PROJECT-BIRO/Biro-1/README.md

# Biro-1
A custom media controller for computers, allowing you to easily change volume, play/pause, skip/rewind, and launch favourite applications. Currently being developed!
