PROJECT-BIRO/Biro-1/3d-models/README.md

# 3D Models
CAD files for Biro-1's case/enclosure, dial, keycaps, etc.
