PROJECT-BIRO/Biro-1/board/README.md

# Printed Circuit Board
Biro-1 schematics and PCB design files
