PROJECT-BIRO/Biro-1/board/Block Diagram/Biro-1-block-diagram.png

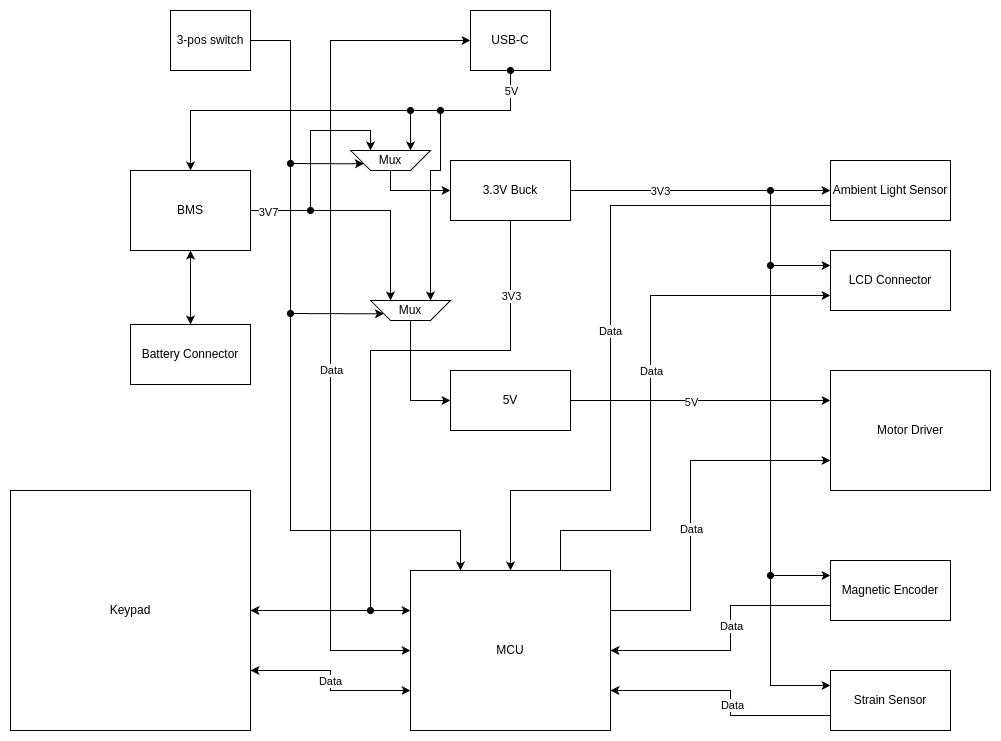
board/Block Diagram/Biro-1-block-diagram.png
