PROJECT-BIRO/Biro-1/board/rev-0/biro-1-rev-0.step

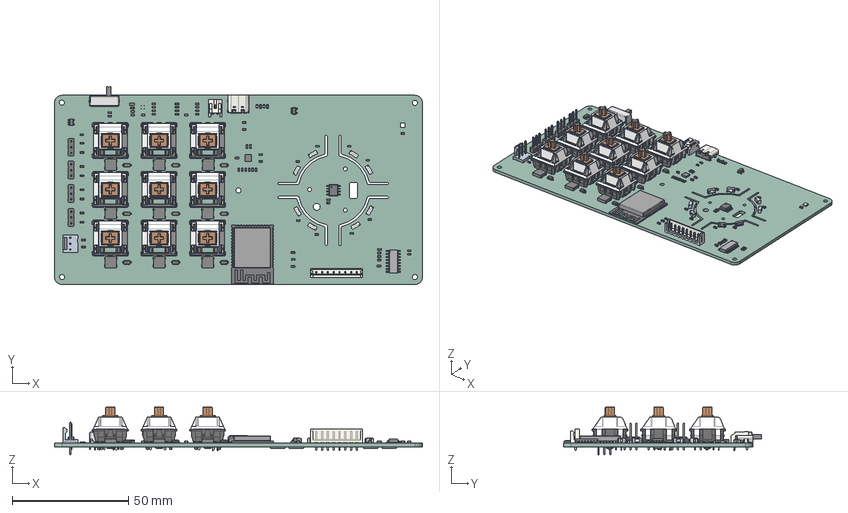
[picture p2: CAD file, 2025-09-03]
board/rev-0/biro-1-rev-0.step
158.5 x 85.2 x 20.6 mm
SW_Cherry_MX_PCB_cp x 9
R_0603_1608Metric x 32
APDS-9306-065
C_0603_1608Metric x 33
SK6812 SIDE-A x 8
CQ assembly
SOT_23_5 x 2
JST_S2B_PH_K
ESP32-S3-WROOM-1
L_0805_2012Metric
D_SOD_123 x 9
JST_B8B_EH_A
PinHeader_1x03_P254mm_Vertical x 4
SLW-1274547-4A-RA-D
LED_0603_1608Metric x 2
USB_C_Receptacle_16P_TopMnt_Horizontal_GCT_USB4105-xx-A
D_0603
R_2512_6332Metric x 4
biro-1-rev-0_PCB
