PROJECT-BIRO/Biro-1/(threads)

Thread 1 (2025-02-17):

Gather firmware libraries

Darth-Raazi, 2025-02-17:
Research which ESP32 libraries we need to use for main functions, including:
- Keys
- Dial
- Bluetooth
- Screen
- Motor

Document them somewhere

pateruu, 2025-04-01:
We are picking libraries as we go so I think it can be closed. We got main libraries selected as well, I believe.

Closed 2025-04-01.

Thread 2 (2025-02-17):

Finalize battery specs

Darth-Raazi, 2025-02-17:
Decide battery specs and configuration. Are we set on 21700? How are we going to configure the 4 cells? Which voltage, 3.7 or 7.4?

Darth-Raazi, 2025-02-21:
3.7V battery will be used as all known components require 3.3V logic, not 5V. Current idea is to configure four 3.7V 21700 cells  in parallel for max capacity

Darth-Raazi, 2025-03-03:
Motor driver requires 6-8V, will boost 3.7V up for that rather than configuring cells in parallel. May decide to add 2 circuit paths (1s and 2s configs) in the future, time and board space permitting

Closed 2025-03-03.

Thread 3 (2025-02-17):

Research BMS

Darth-Raazi, 2025-02-17:
Draft initial plan for BMS. Custom or COTS? Which ICs will we use? What's the voltage step-down/step-up path? BMS circuitry integrated into main board or as a separate daughter board?

Thread 4 (2025-02-17):

ESP32 Dev Env Setup

Darth-Raazi, 2025-02-17:
Order dev boards and setup the ESP IDF. Compile and run some test code

Darth-Raazi, 2025-02-21:
Dev boards arrived!

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

Darth-Raazi, 2025-03-03:
Others to follow setup instructions and verify that they're correct

Closed 2025-03-23.

Thread 7 (2025-02-23):

Research Motor

Darth-Raazi, 2025-02-23:
SmartKnob uses a specific motor. Look into:
- Can we get that one and for how much?
- Is there a cheaper one that works just as well?
- Are others size compatible?
- Input voltage and current draw?
- Electrical connections and firmware support

Darth-Raazi, 2025-03-03:
Decided to go with the official sparkfun motors for first boards to cut down on risk despite higher price tags

Closed 2025-03-03.
