PROJECT-BIRO/Biro-1/board/Block Diagram/Biro-1-block-diagram.pdf

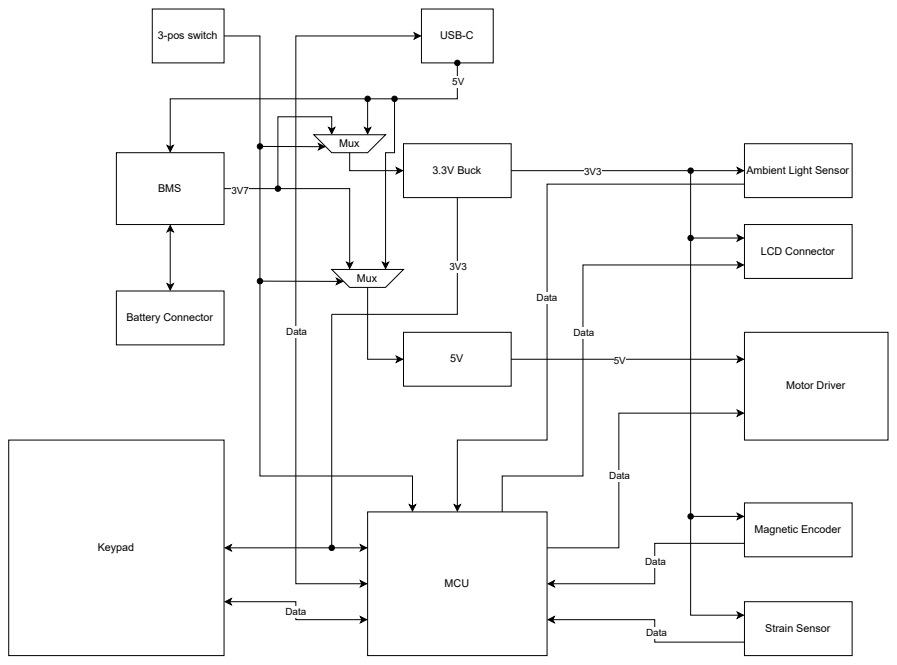
[picture p3: page 1]
3-pos switch; USB-C; MCU; Keypad; Motor Driver; LCD Connector; Magnetic Encoder; Strain Sensor; 3.3V Buck; BMS; Battery Connector; Data; Mux

Ambient Light Sensor
