PROJECT-BIRO/Biro-1/board/biro-battery-schematic/biro-0.pdf

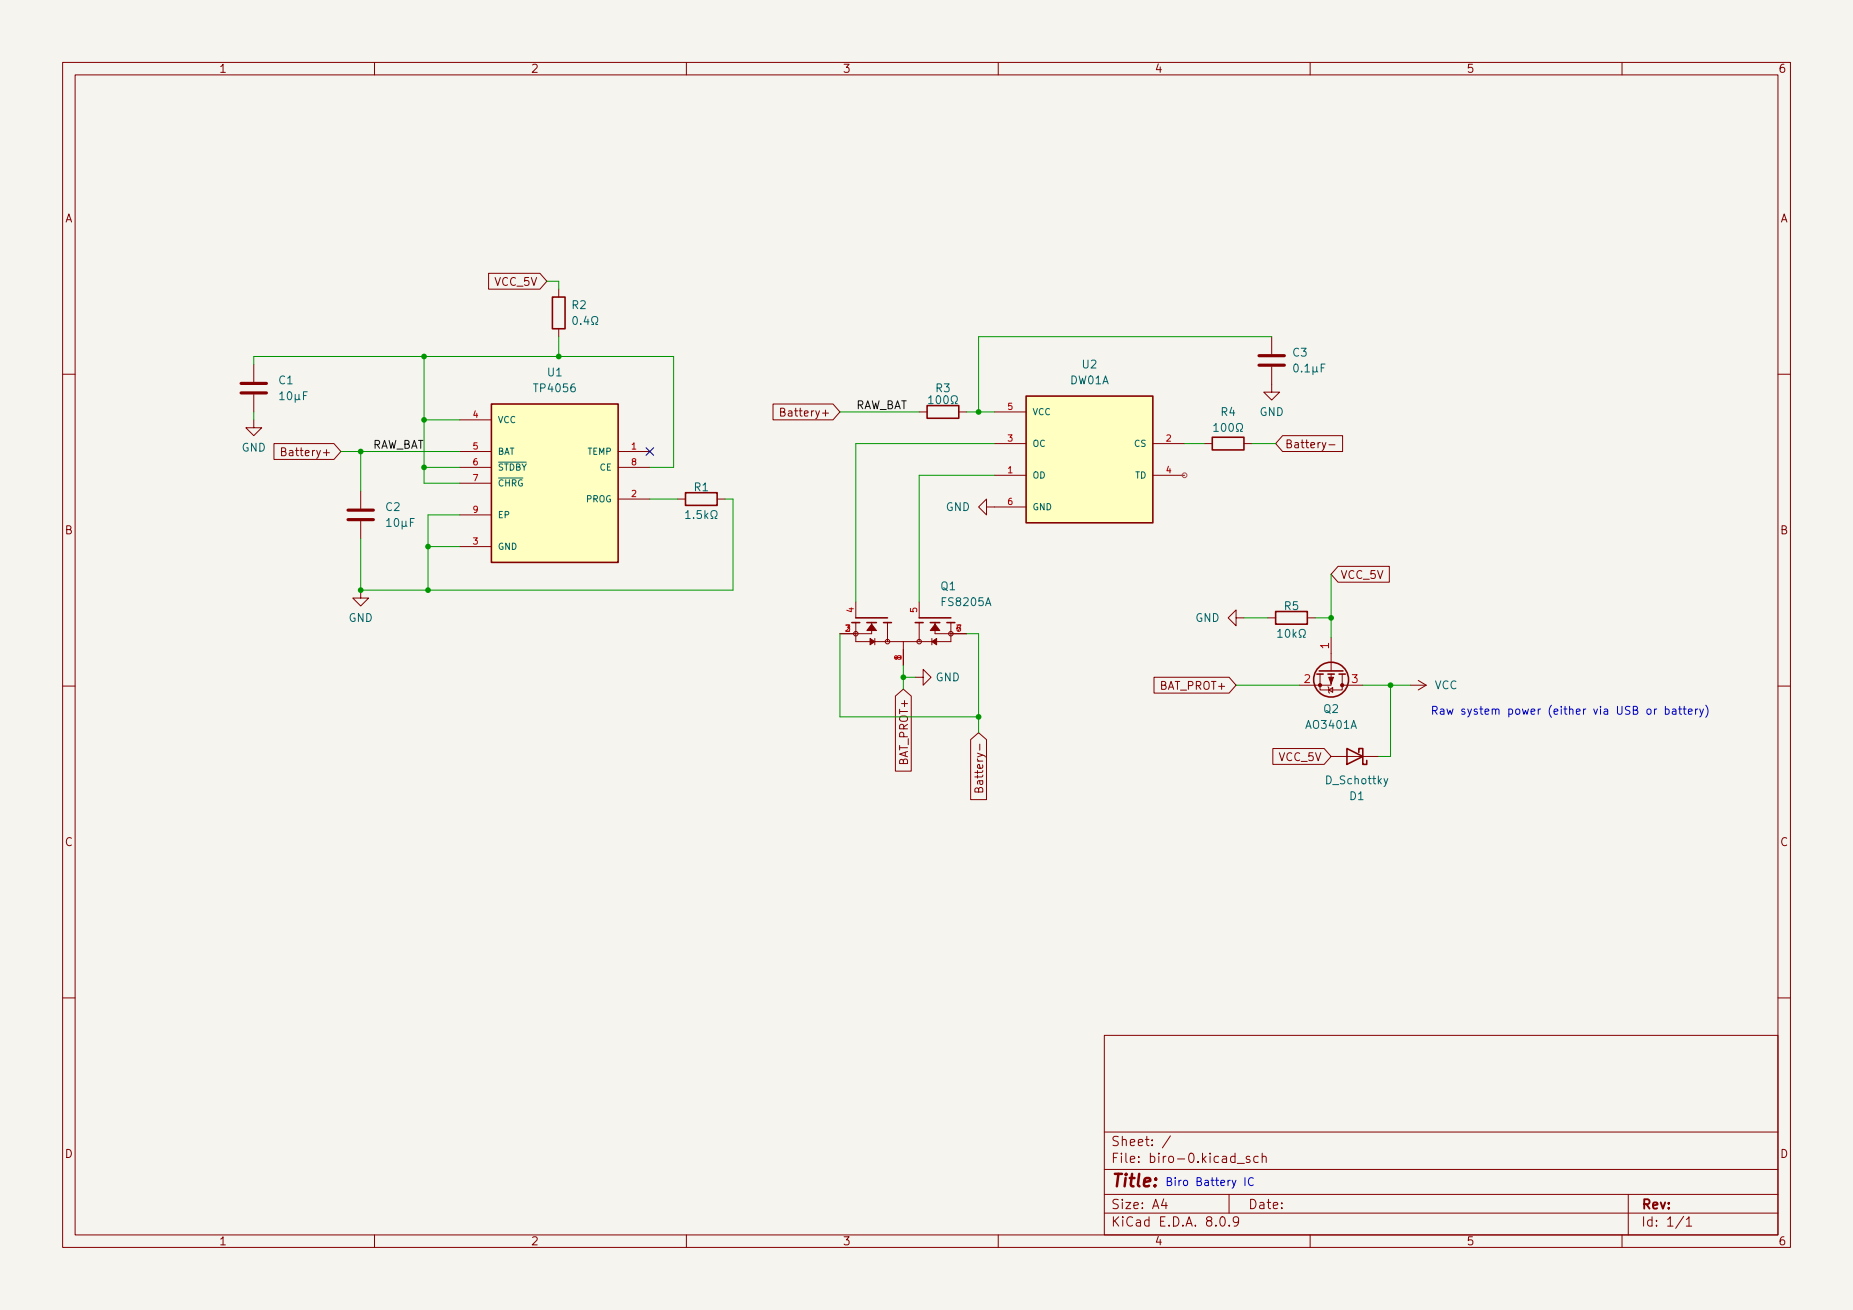
[picture p4: page 1]
