PROJECT-BIRO/Biro-1/board/rev-0/biro-1-rev-0.pdf

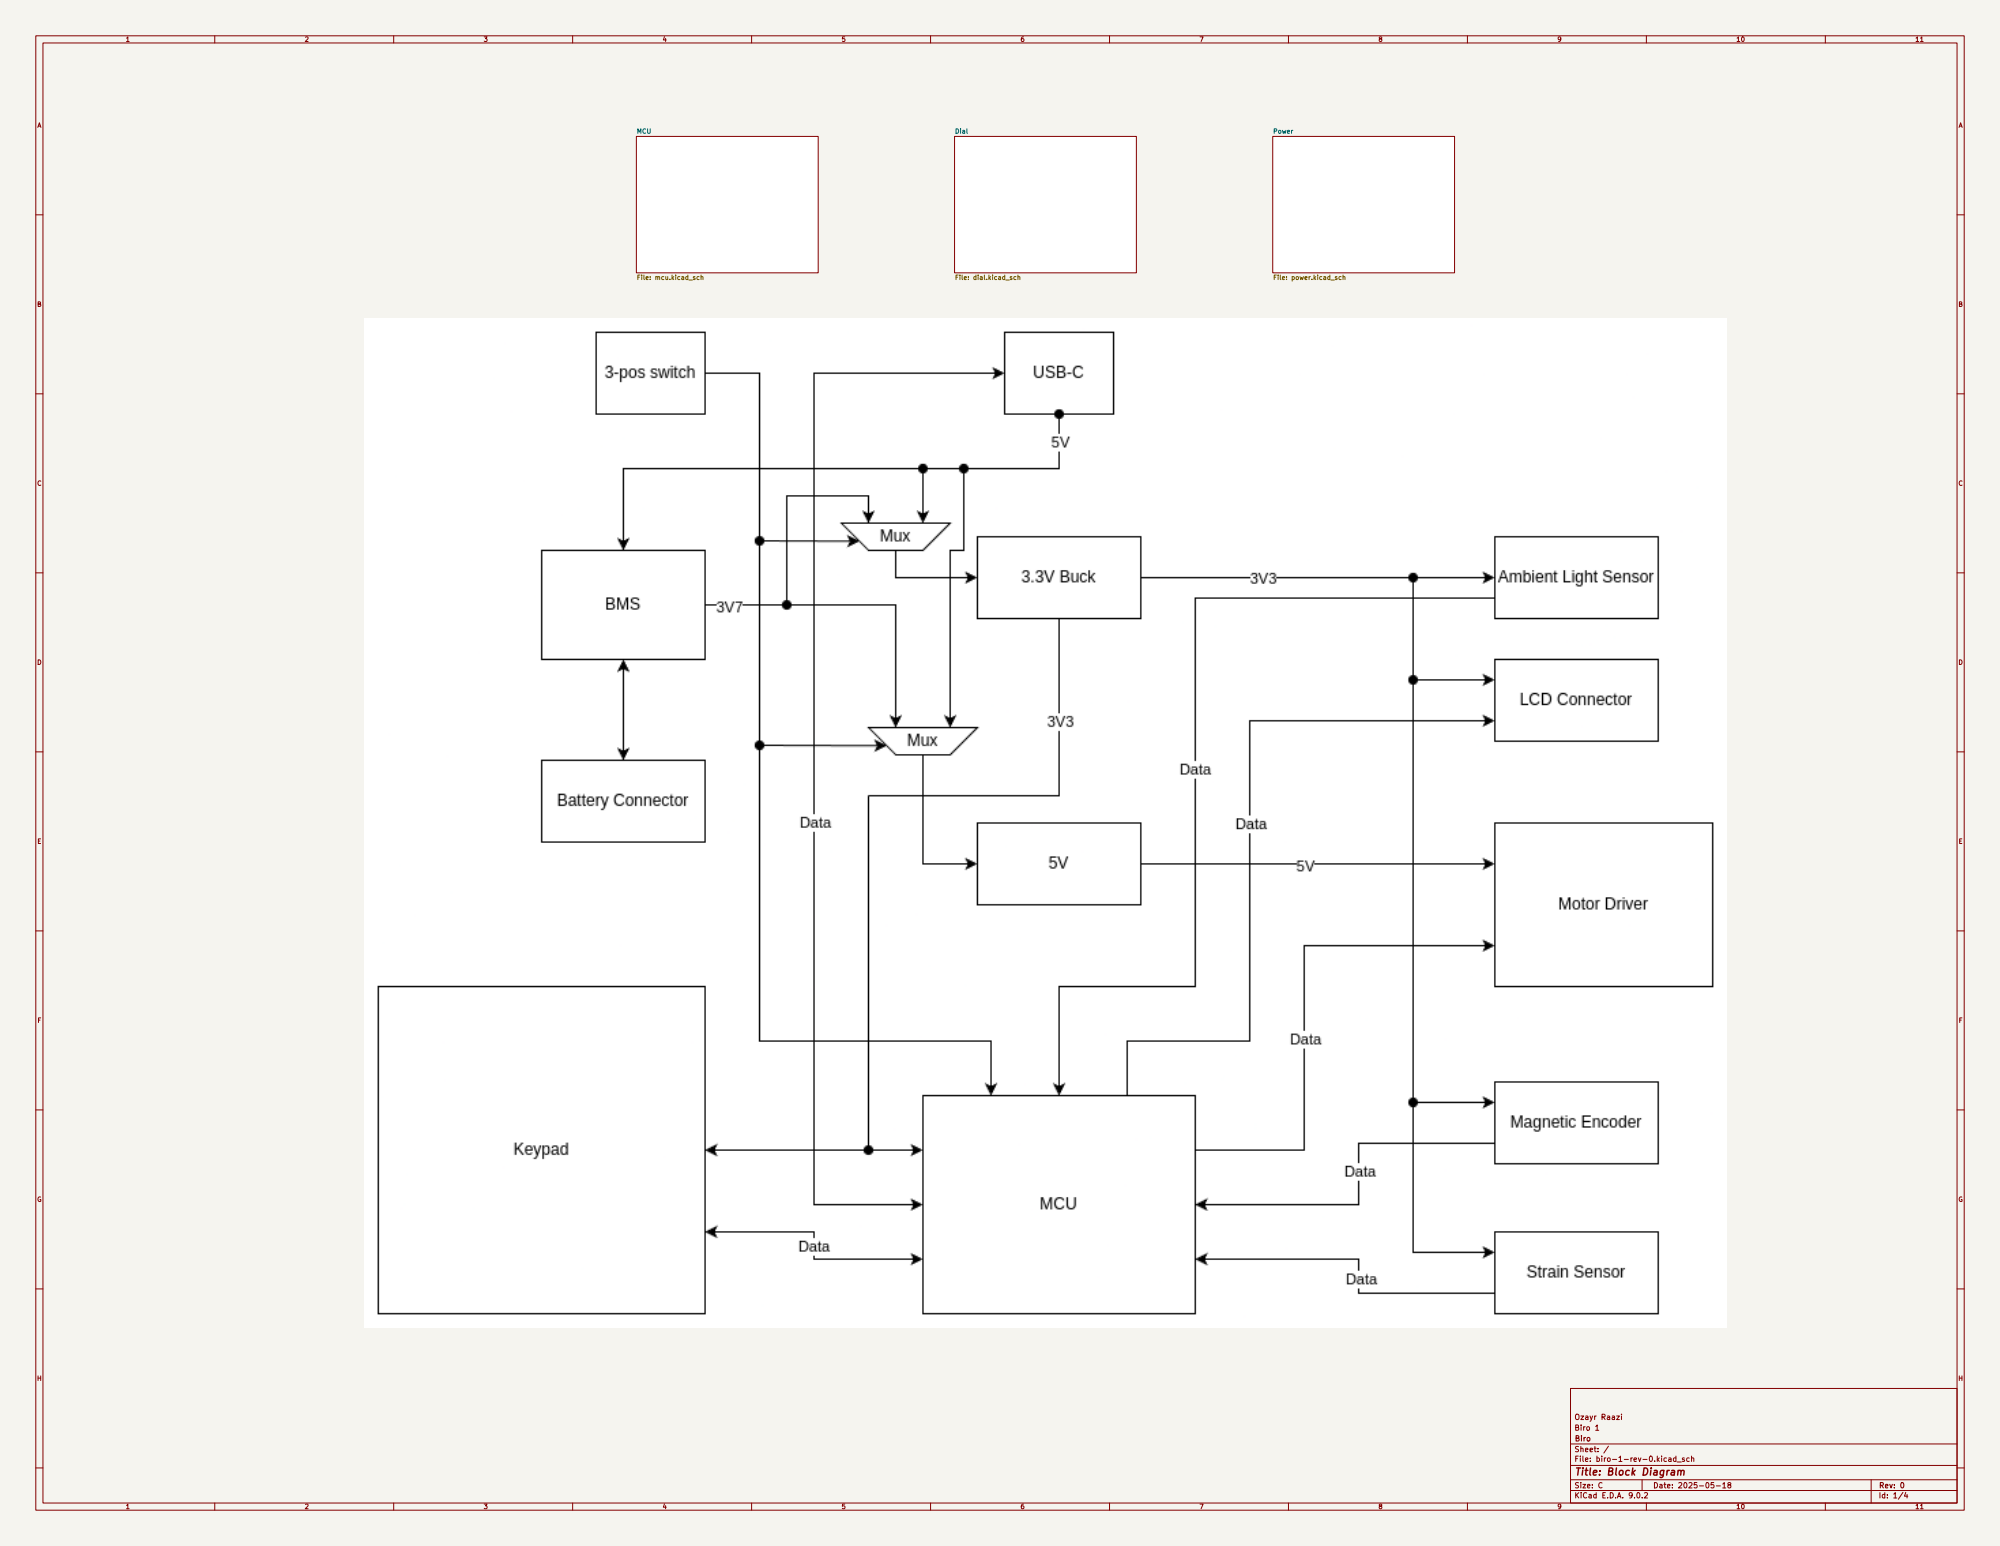
[picture p5: page 1]

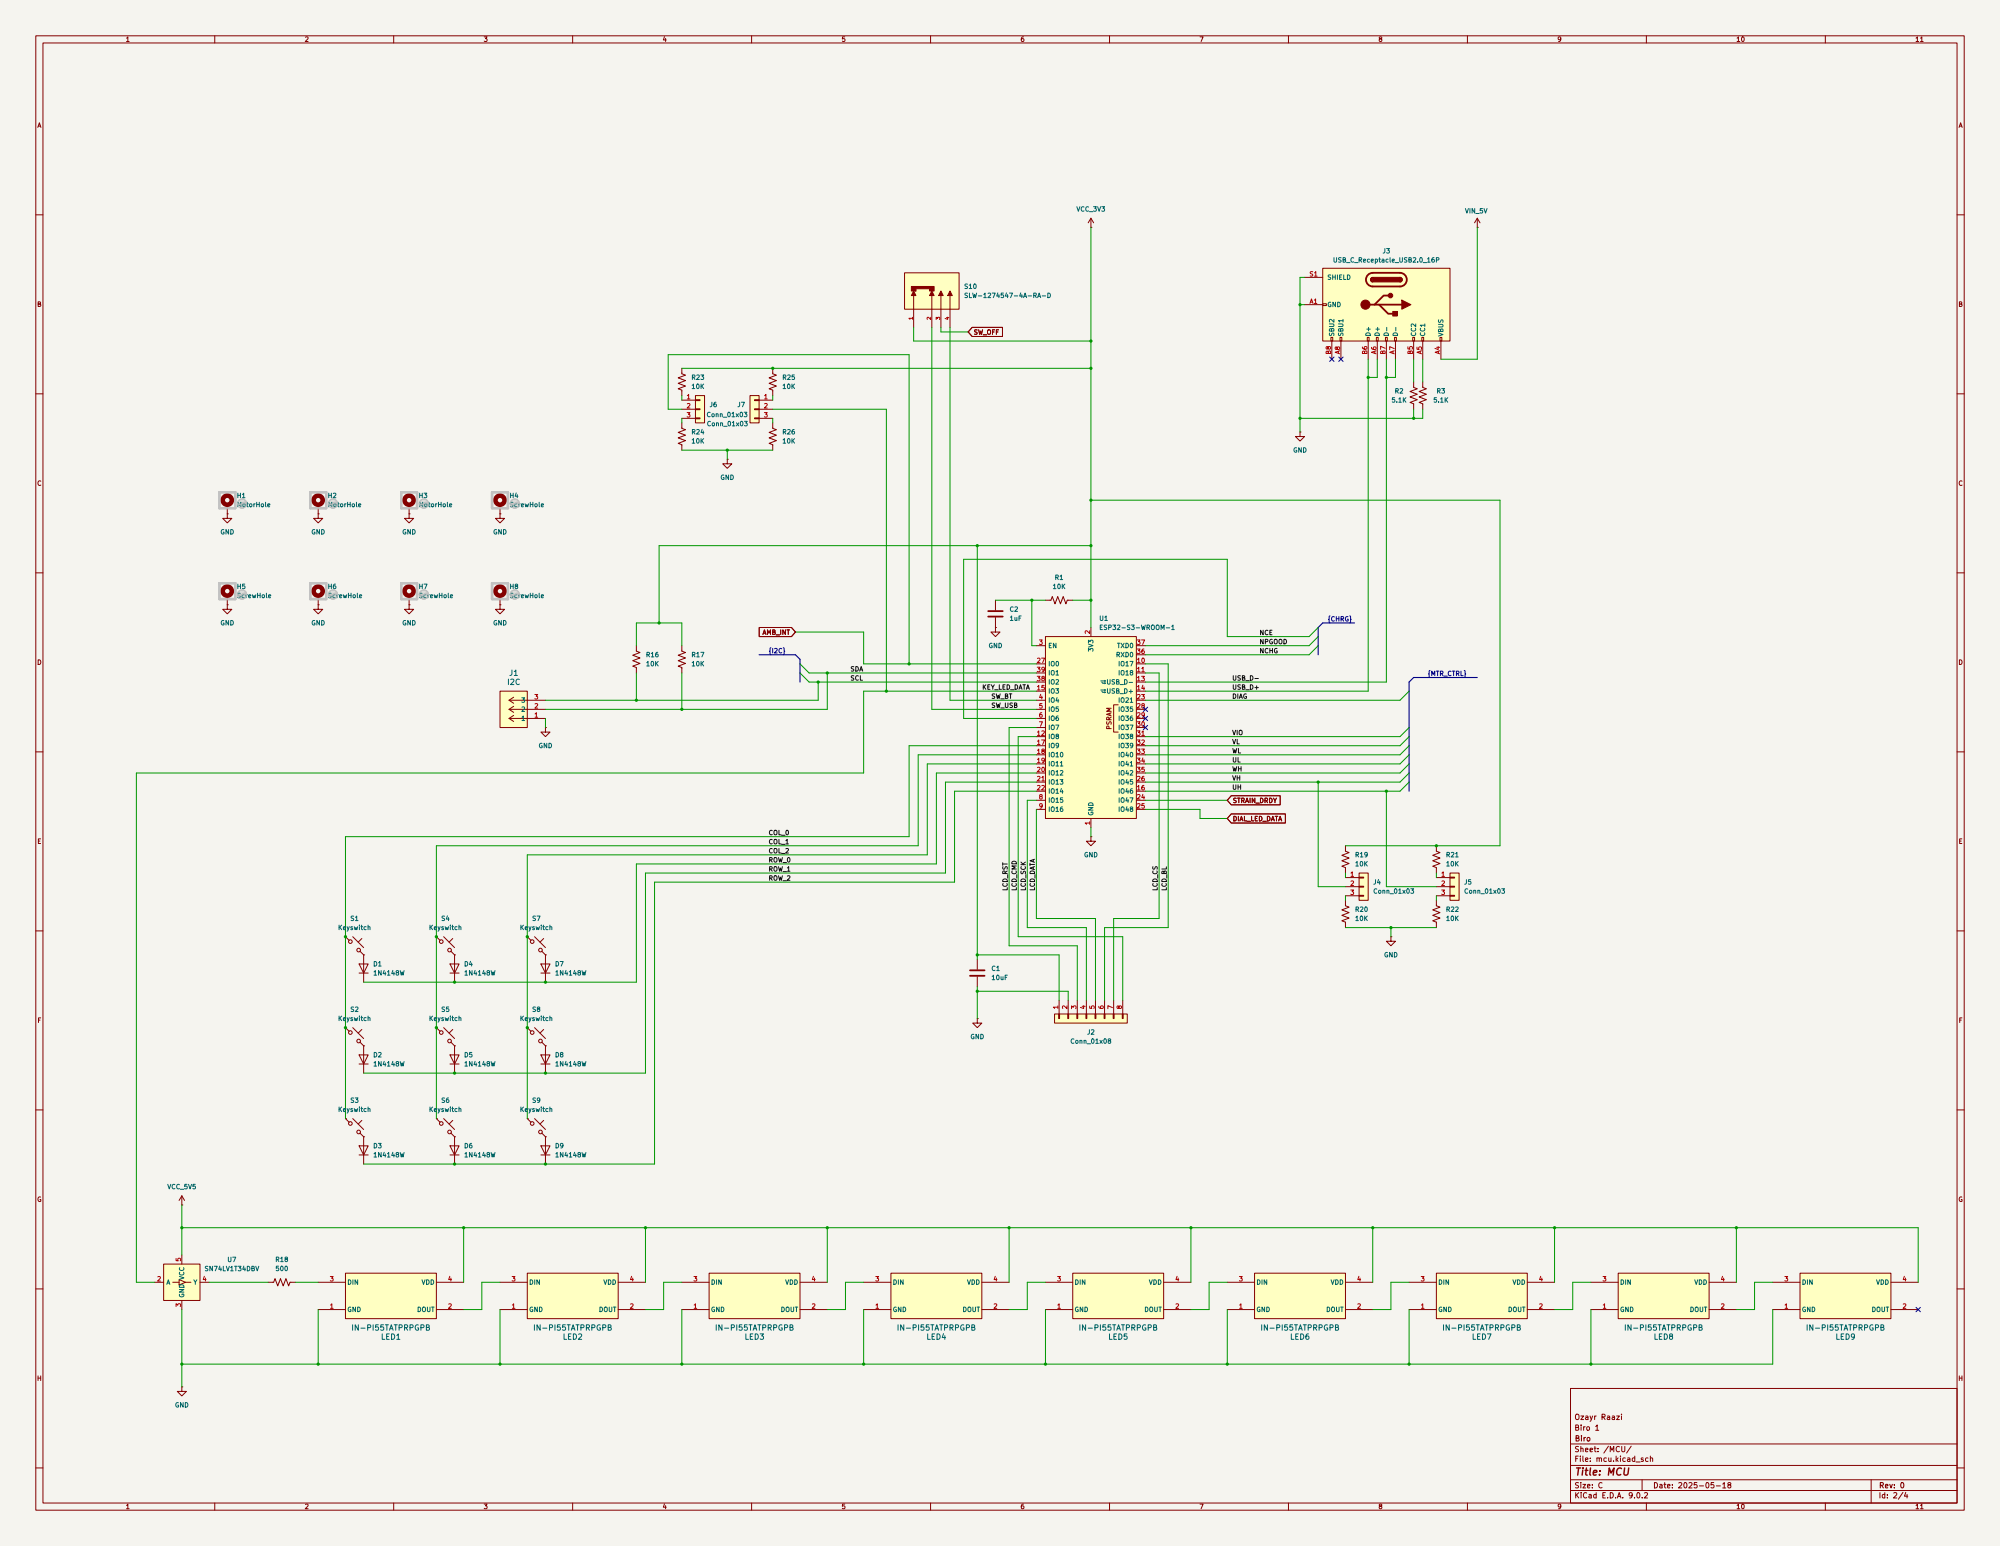
[picture p6: page 2]

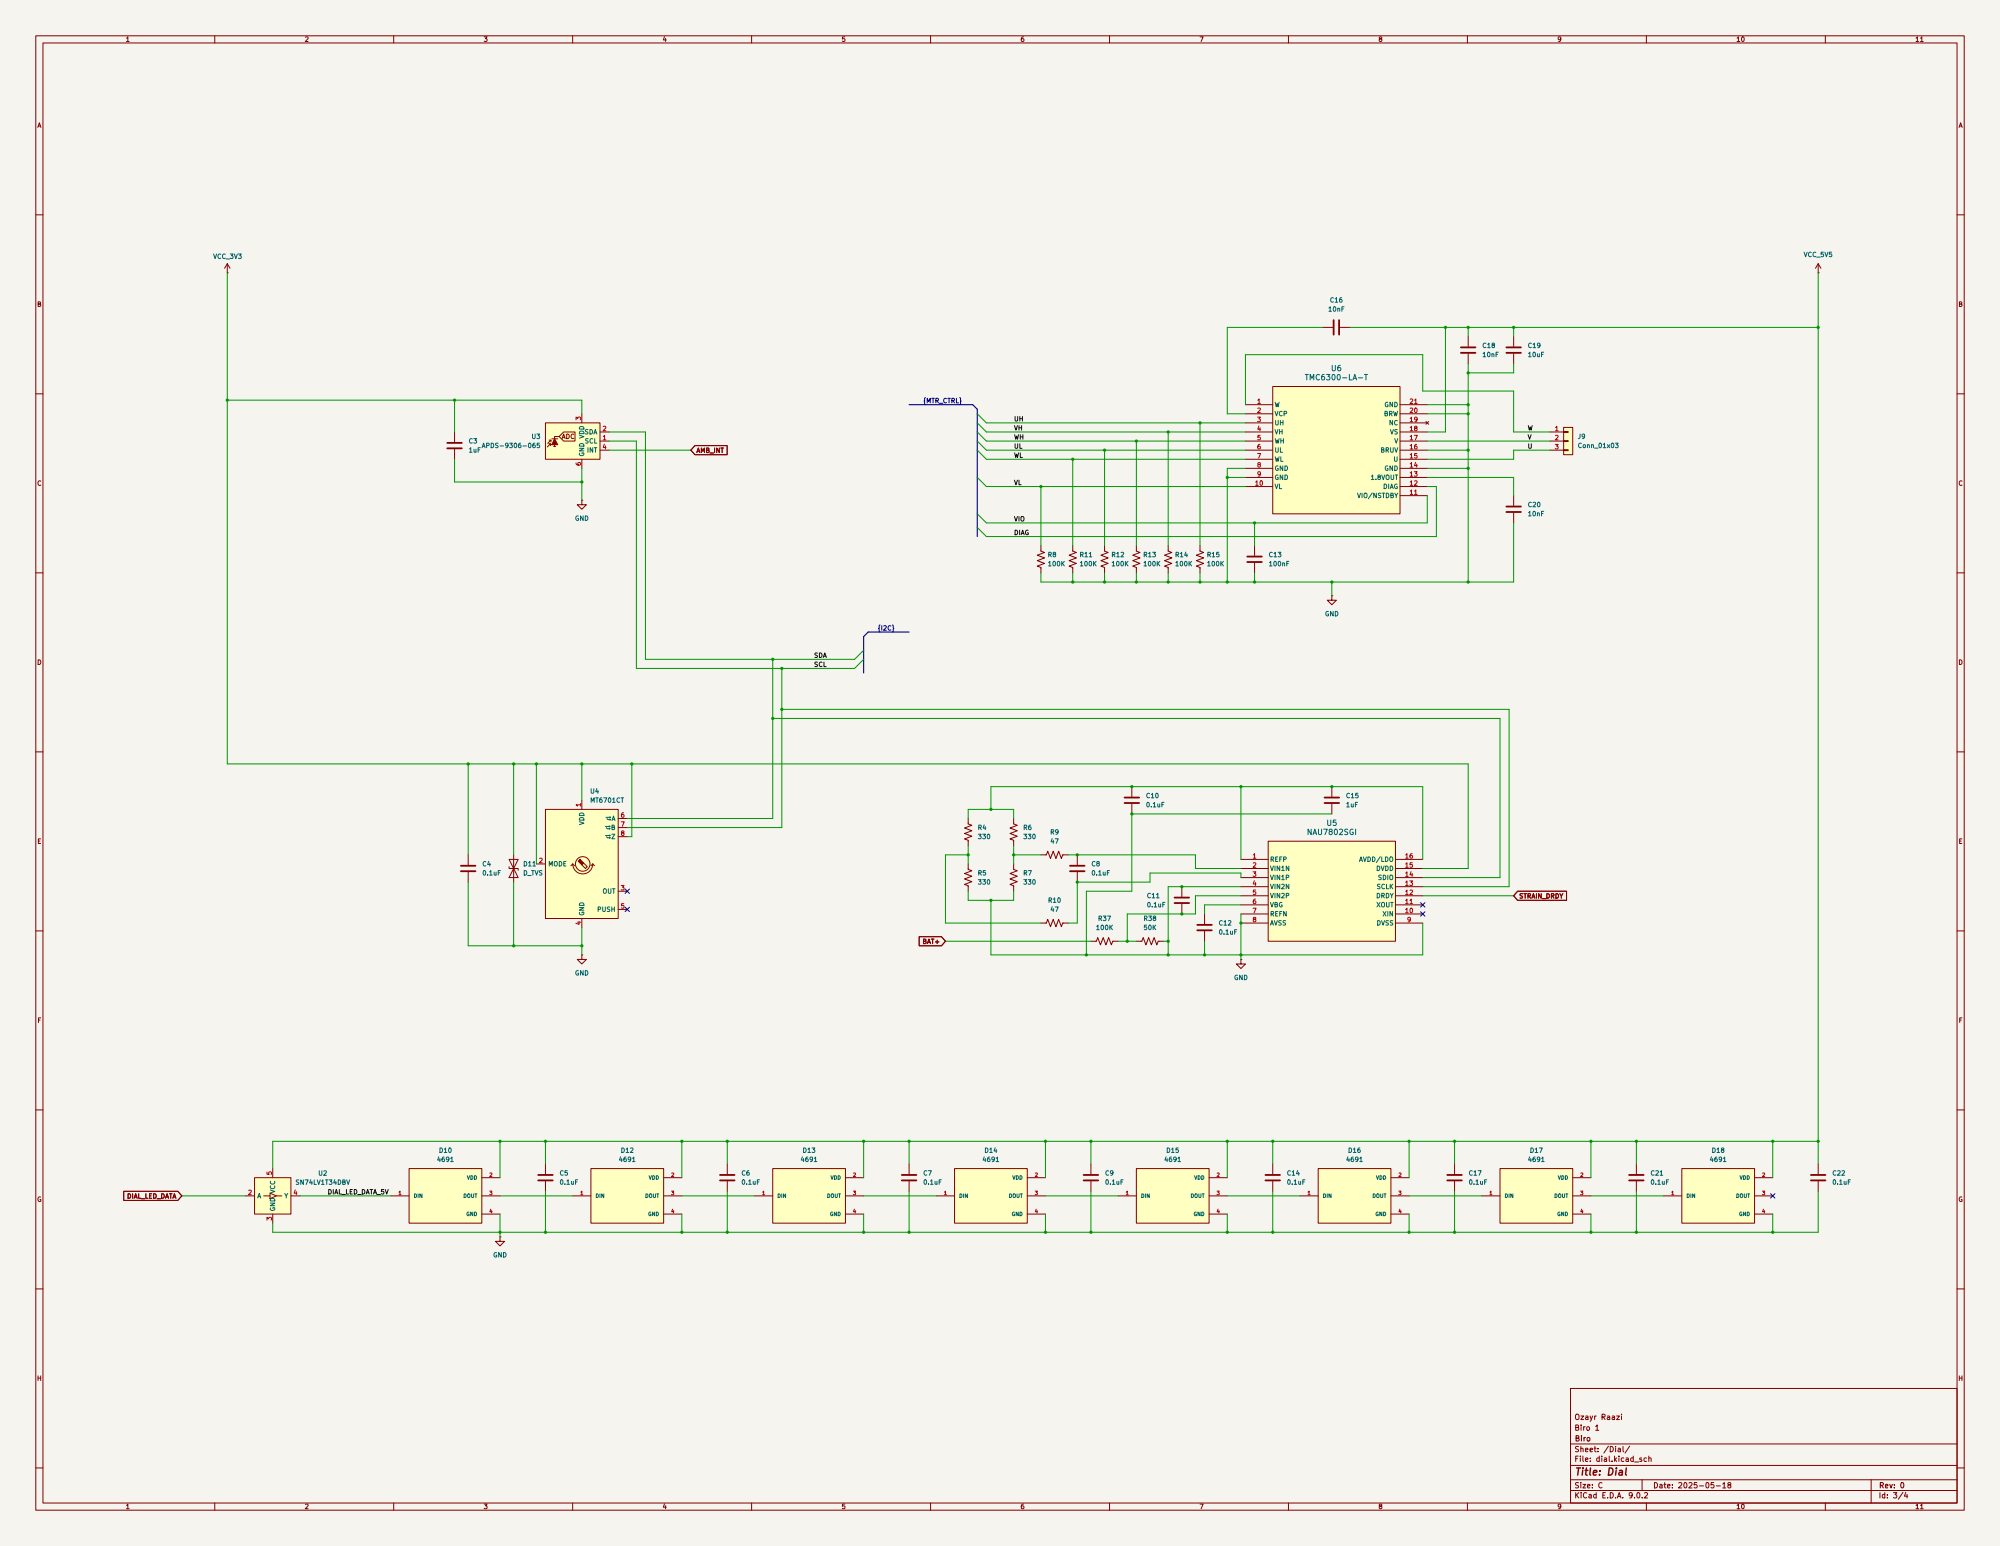
[picture p7: page 3]

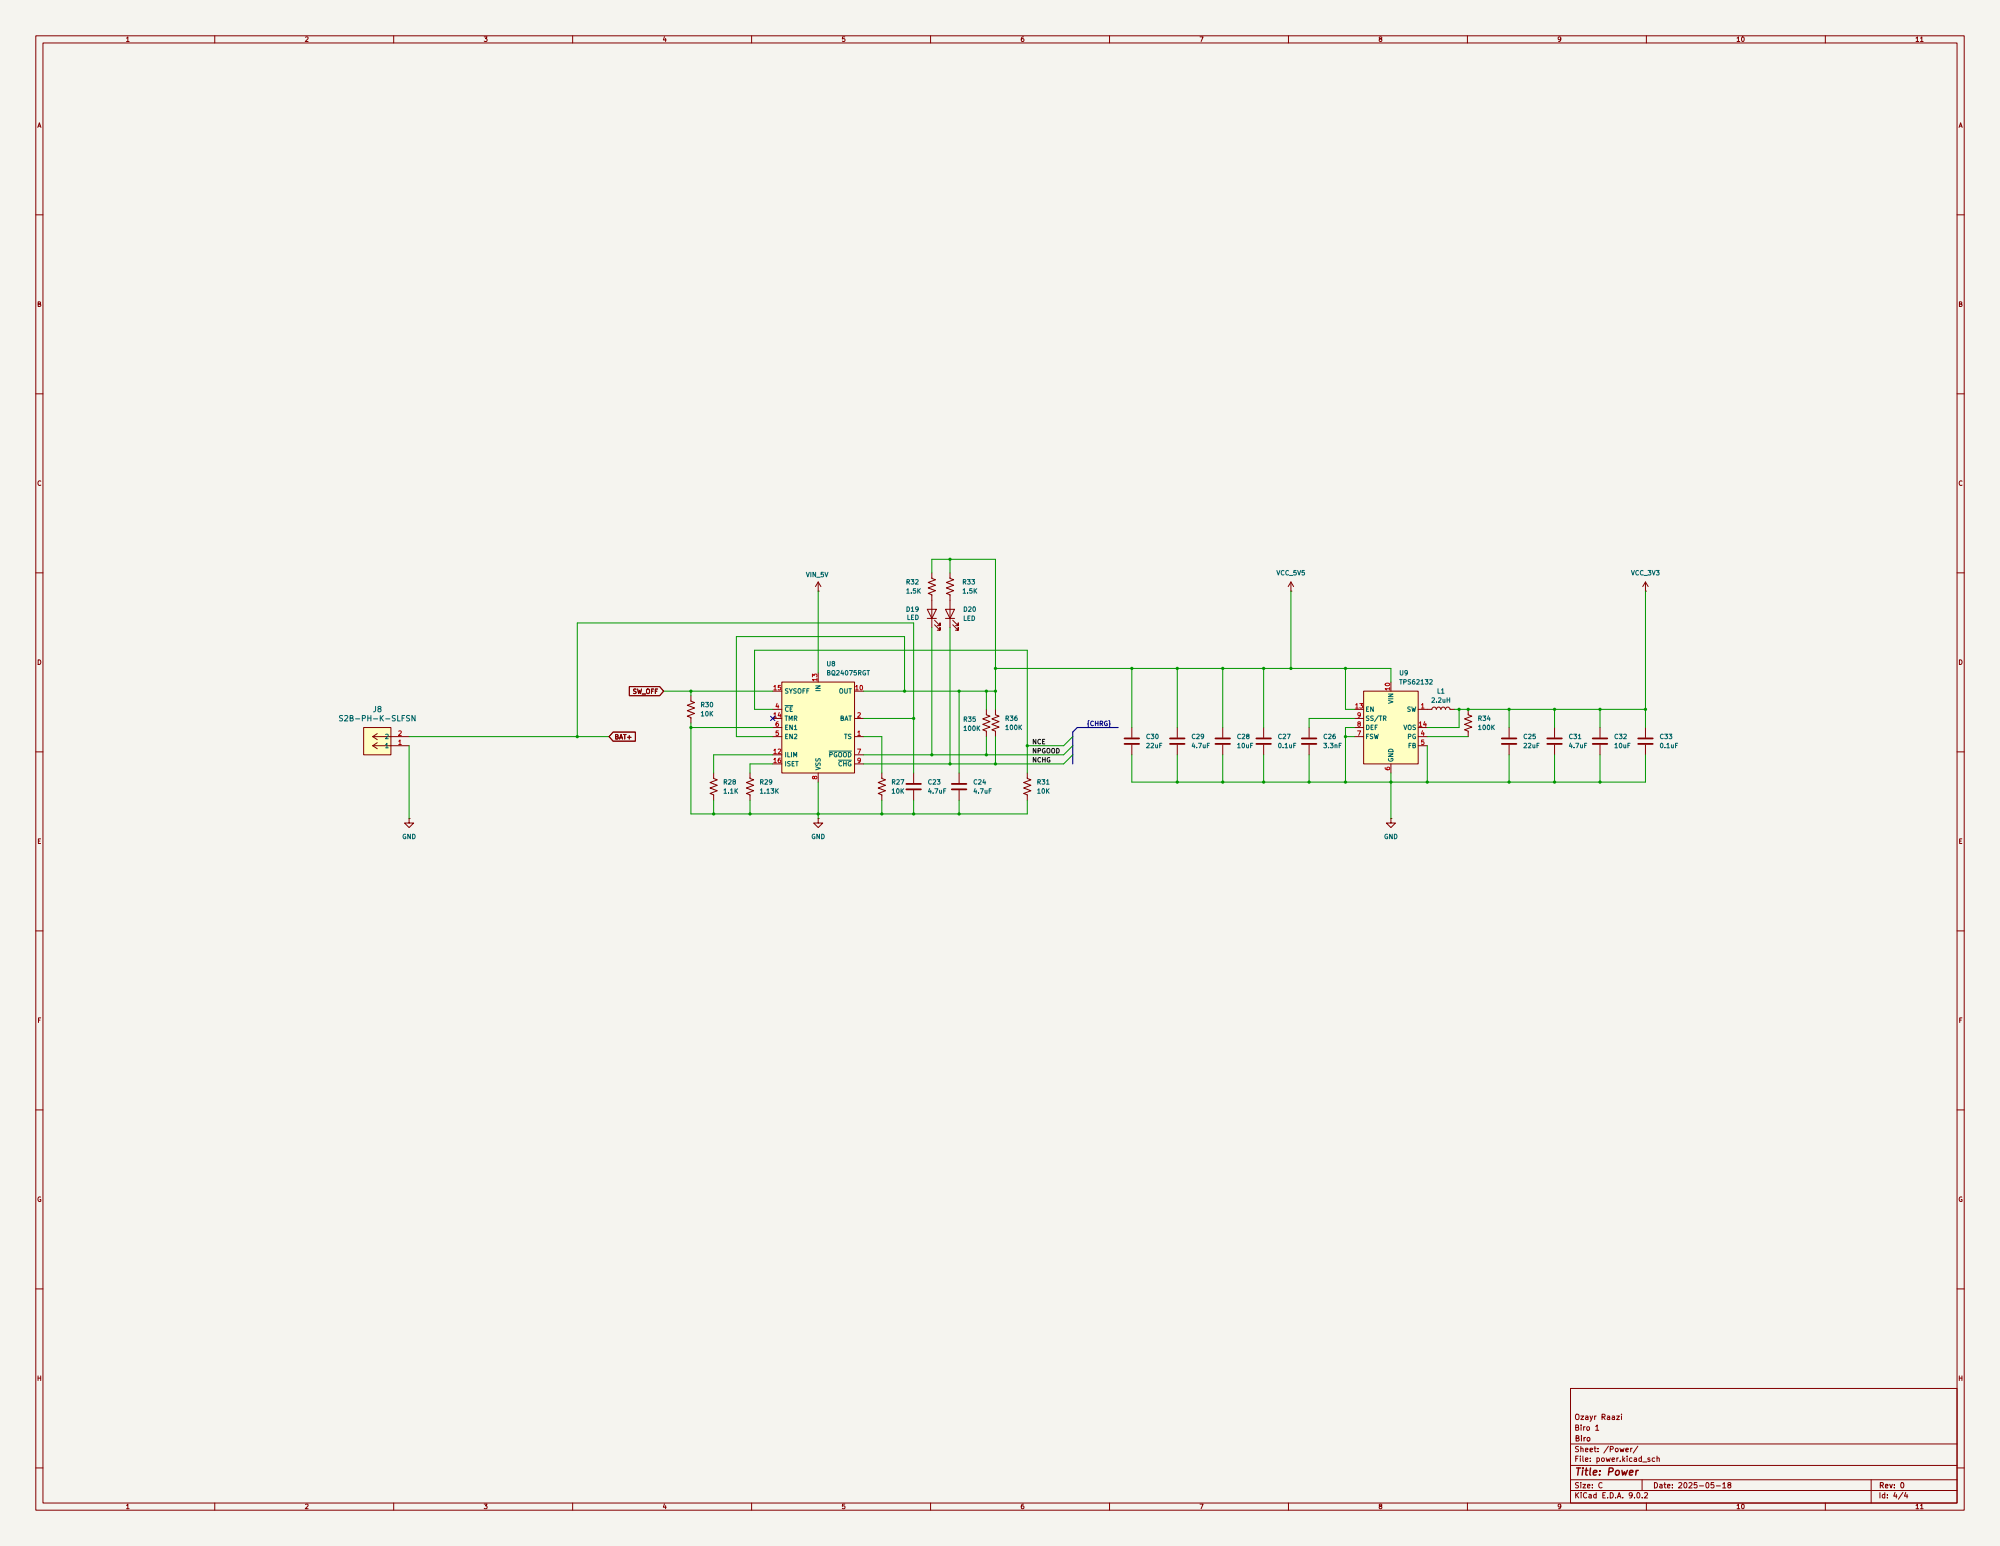
[picture p8: page 4]
