PROJECT-BIRO/Biro-1/board/rev-0/biro-1-rev-0.kicad_pcb

## KiCad design board/rev-0/biro-1-rev-0.kicad_pcb (2025-09-03)

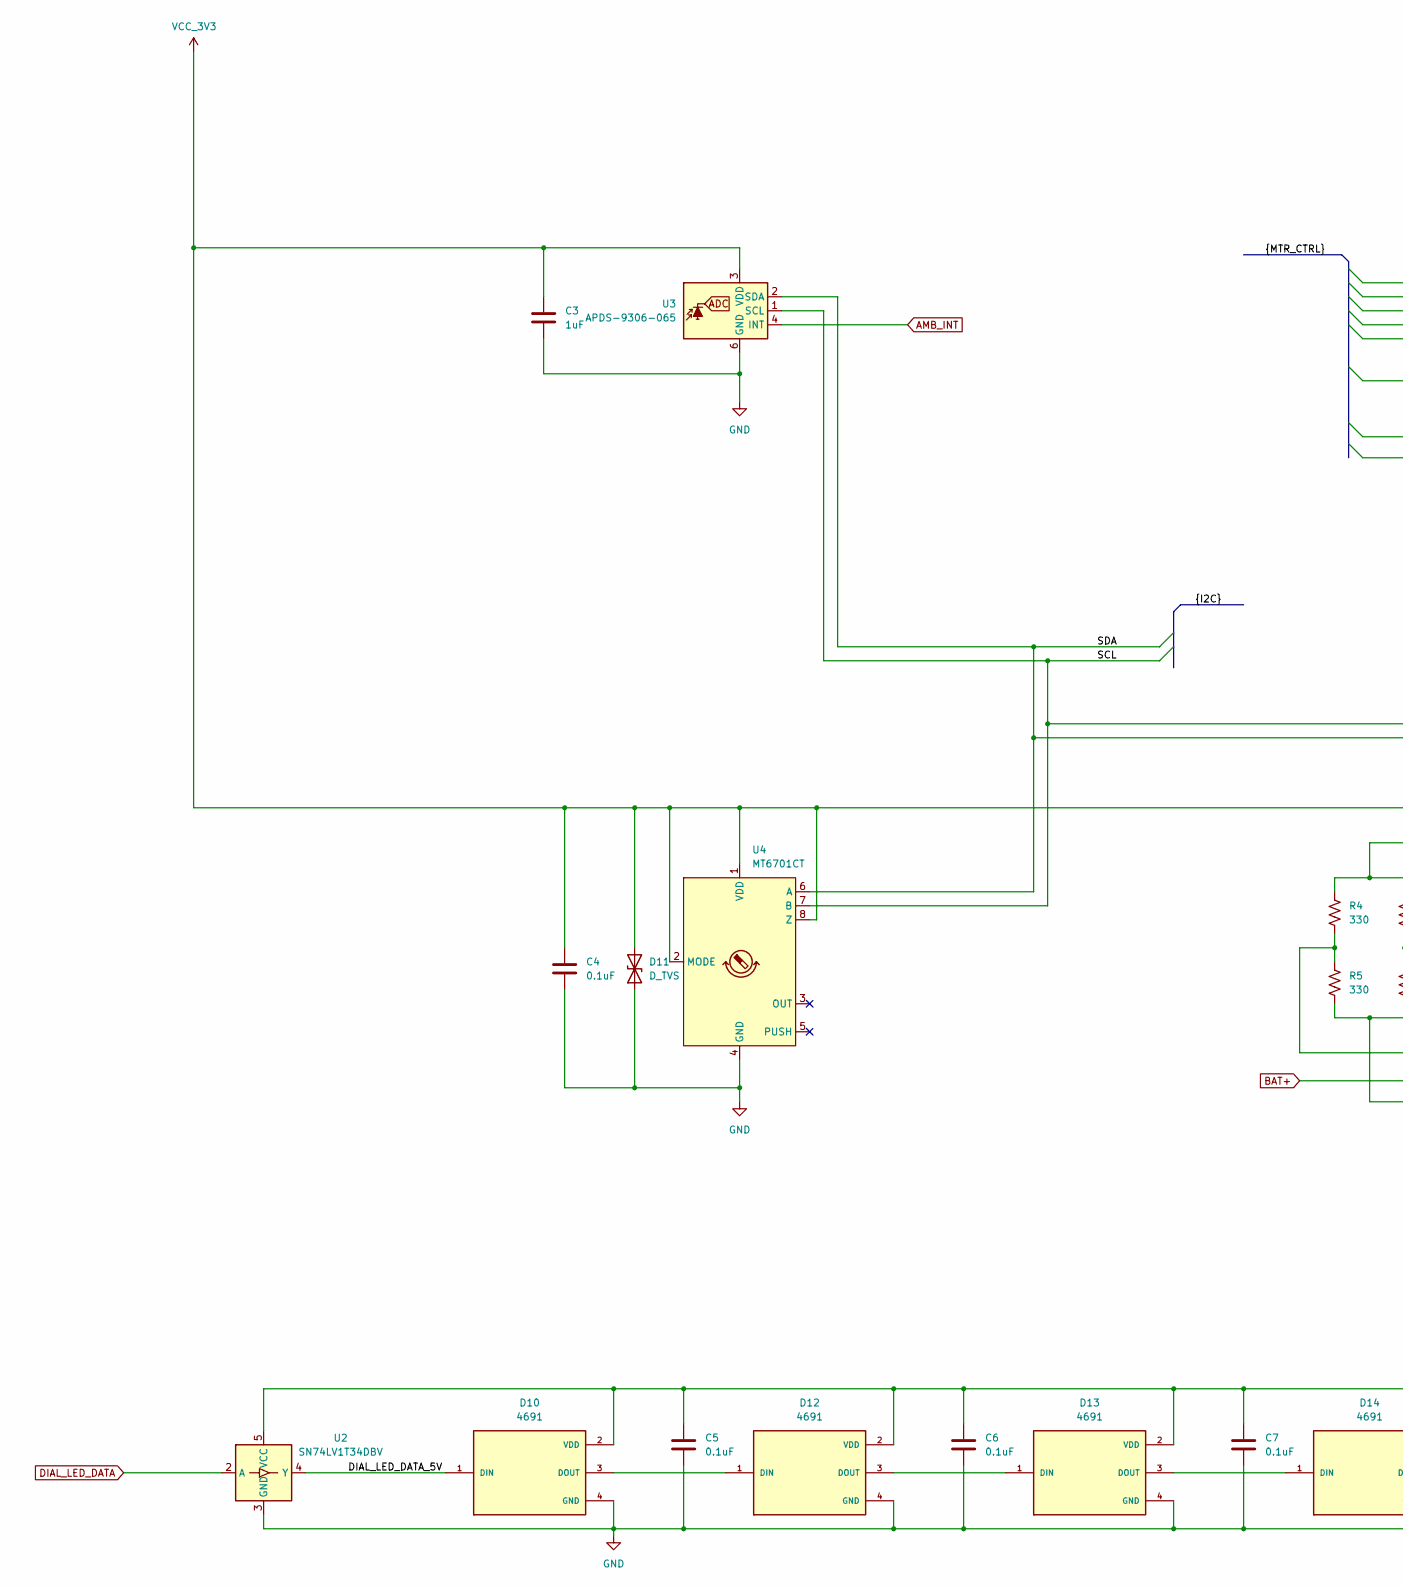
[picture p9: schematic dial.kicad_sch, part in row 1, column 1]

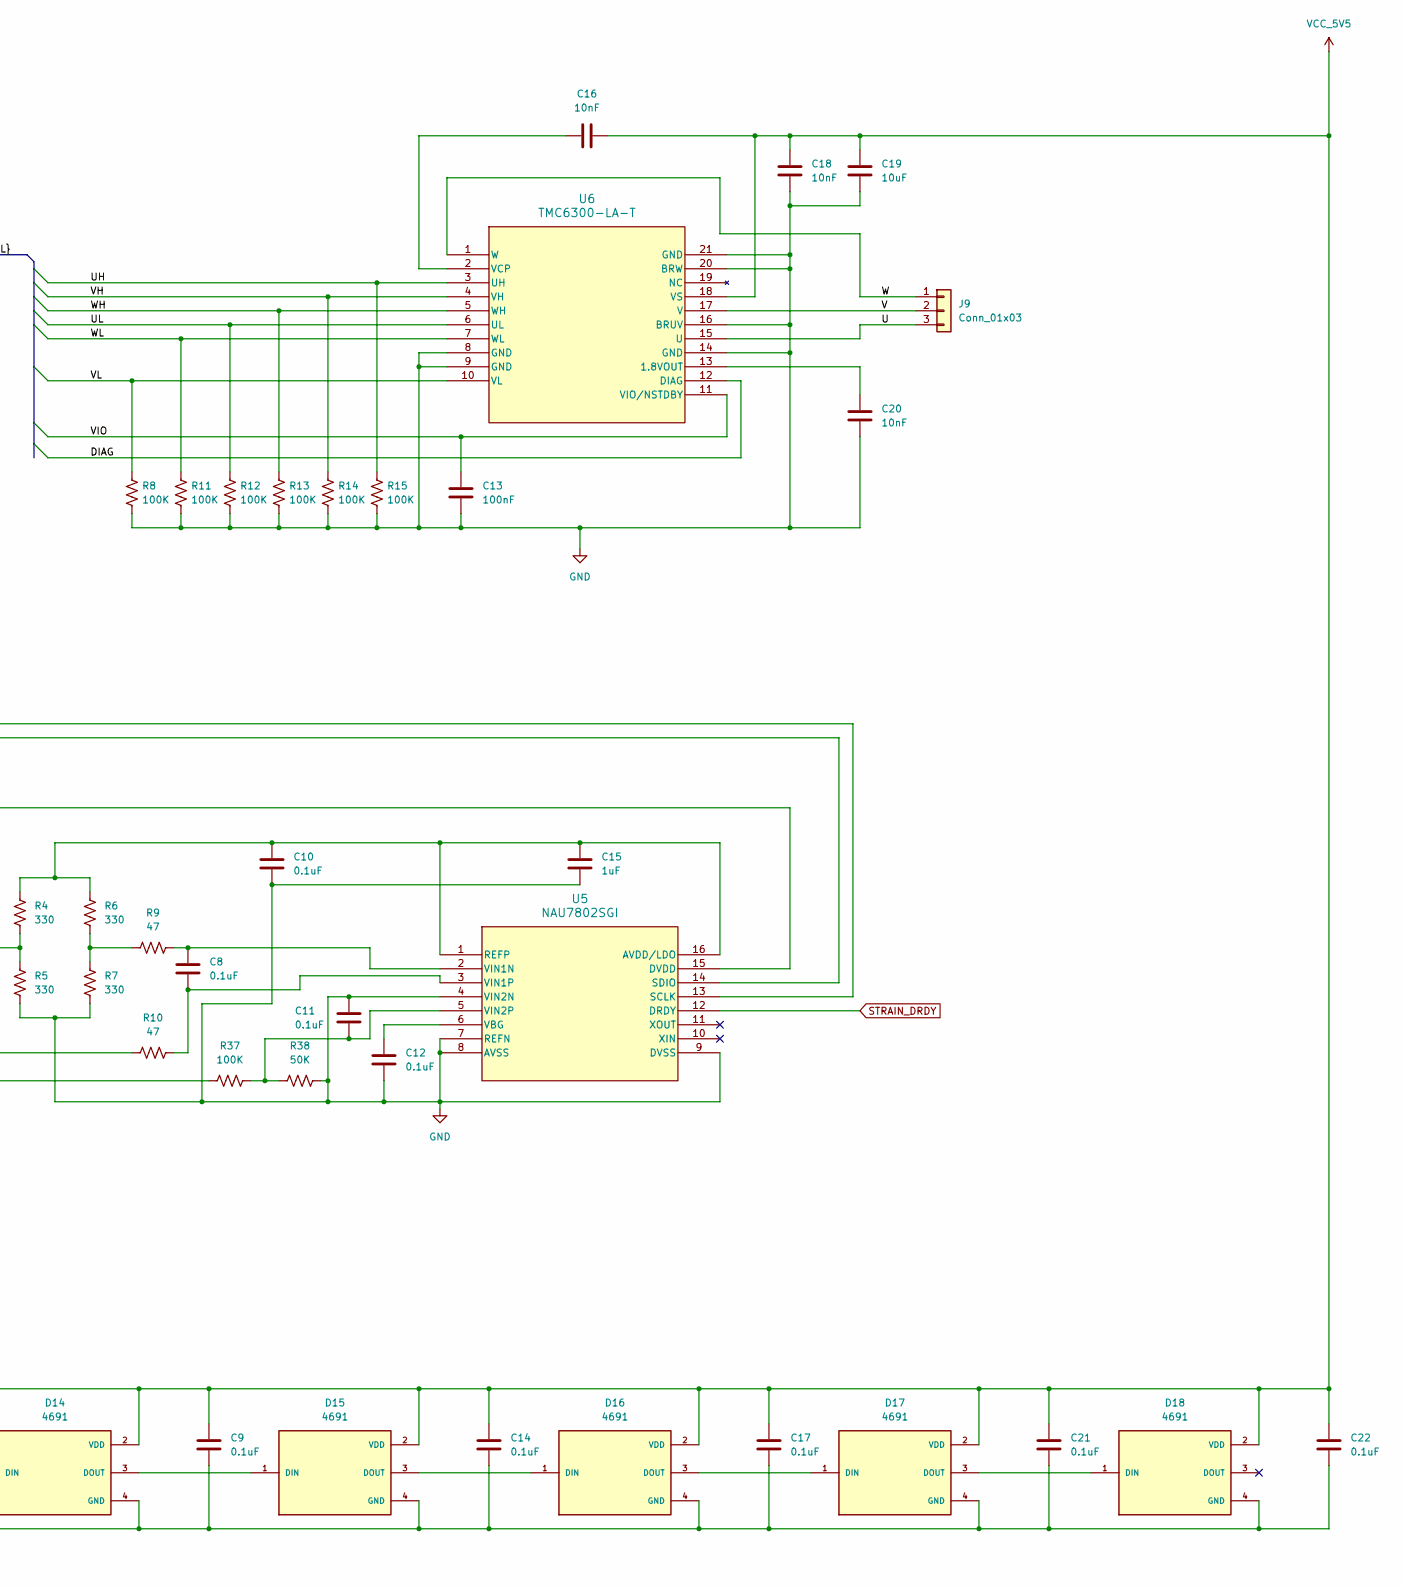
[picture p10: schematic dial.kicad_sch, part in row 1, column 2]

Parts:
C3, C15: 1uF; C_0603_1608Metric
C4, C5, C6, C7, C8, C9, C10, C11, C12, C14, C17, C21, C22: 0.1uF; C_0603_1608Metric
C13: 100nF; C_0603_1608Metric
C16, C18, C20: 10nF; C_0603_1608Metric
C19: 10uF; C_0603_1608Metric
D10, D12, D13, D14, D15, D16, D17, D18: 4691; LED_4691
D11: D_TVS; D_0603_1608Metric
J9: Conn_01x03; SolderWire-2sqmm_1x03_P7.8mm_D2mm_OD3.9mm
R4, R5, R6, R7: 330; R_2512_6332Metric
R8, R11, R12, R13, R14, R15, R37: 100K; R_0603_1608Metric
R9, R10: 47; R_0603_1608Metric
R38: 50K; R_0603_1608Metric
U2: SN74LV1T34DBV; SOT-23-5
U3: APDS-9306-065; Broadcom_DFN-6_2x2mm_P0.65mm
U4: MT6701CT; SO-8_3.9x4.9mm_P1.27mm
U5: NAU7802SGI; SOI16_NAU7802SGI_NUV
U6: TMC6300-LA-T; 21-100586_K2033&plus_1C_ADI

Connections:
/Dial/DIAG: U6.12 (DIAG)
/Dial/DIAL_LED_DATA_5V: D10.1 (DIN), U2.4 (Y)
/Dial/SCL: U3.1 (SCL), U4.7 (B), U5.13 (SCLK)
/Dial/SDA: U3.2 (SDA), U4.6 (A), U5.14 (SDIO)
/Dial/U: J9.3, U6.15 (U)
/Dial/UH: R15.1, U6.3 (UH)
/Dial/UL: R12.1, U6.6 (UL)
/Dial/V: J9.2, U6.17 (V)
/Dial/VH: R14.1, U6.4 (VH)
/Dial/VIO: C13.1, U6.11 (VIO/NSTDBY)
/Dial/VL: R8.1, U6.10 (VL)
/Dial/W: J9.1, U6.1 (W)
/Dial/WH: R13.1, U6.5 (WH)
/Dial/WL: R11.1, U6.7 (WL)
AMB_INT: U3.4 (INT); also elsewhere on the board
BAT+: R37.1; also elsewhere on the board
DIAL_LED_DATA: U2.2 (A); also elsewhere on the board
GND: C3.2, C4.2, C5.2, C6.2, C7.2, C9.2, C10.2, C11.2, C12.2, C13.2, C14.2, C15.2, C17.2, C18.2, C19.2, C20.1, C21.2, C22.2, D10.4 (GND), D11.1 (A1), D12.4 (GND), D13.4 (GND), D14.4 (GND), D15.4 (GND), D16.4 (GND), D17.4 (GND), D18.4 (GND), R5.2, R7.2, R8.2, R11.2, R12.2, R13.2, R14.2, R15.2, R38.2, U2.3 (GND), U3.6 (GND), U4.4 (GND), U5.4 (VIN2N), U5.7 (REFN), U5.8 (AVSS), U5.9 (DVSS), U6.8 (GND), U6.9 (GND), U6.14 (GND), U6.16 (BRUV), U6.20 (BRW), U6.21 (GND); also elsewhere on the board
unnamed: D10.3 (DOUT), D12.1 (DIN)
unnamed: D12.3 (DOUT), D13.1 (DIN)
unnamed: D13.3 (DOUT), D14.1 (DIN)
unnamed: D14.3 (DOUT), D15.1 (DIN)
unnamed: D15.3 (DOUT), D16.1 (DIN)
unnamed: D16.3 (DOUT), D17.1 (DIN)
unnamed: D17.3 (DOUT), D18.1 (DIN)
unnamed: R6.2, R7.1, R9.1
unnamed: R4.2, R5.1, R10.1
unnamed: C10.1, C15.1, R4.1, R6.1, U5.1 (REFP), U5.16 (AVDD/LDO)
unnamed: C12.1, U5.6 (VBG)
unnamed: C8.1, R9.2, U5.2 (VIN1N)
unnamed: C8.2, R10.2, U5.3 (VIN1P)
unnamed: C11.1, R37.2, R38.1, U5.5 (VIN2P)
unnamed: C20.2, U6.13 (1.8VOUT)
unnamed: C16.1, U6.2 (VCP)
STRAIN_DRDY: U5.12 (DRDY); also elsewhere on the board
VCC_3V3: C3.1, C4.1, D11.2 (A2), U3.3 (VDD), U4.1 (VDD), U4.2 (MODE), U4.8 (Z), U5.15 (DVDD); also elsewhere on the board
VCC_5V5: C5.1, C6.1, C7.1, C9.1, C14.1, C16.2, C17.1, C18.1, C19.1, C21.1, C22.1, D10.2 (VDD), D12.2 (VDD), D13.2 (VDD), D14.2 (VDD), D15.2 (VDD), D16.2 (VDD), D17.2 (VDD), D18.2 (VDD), U2.5 (VCC), U6.18 (VS); also elsewhere on the board

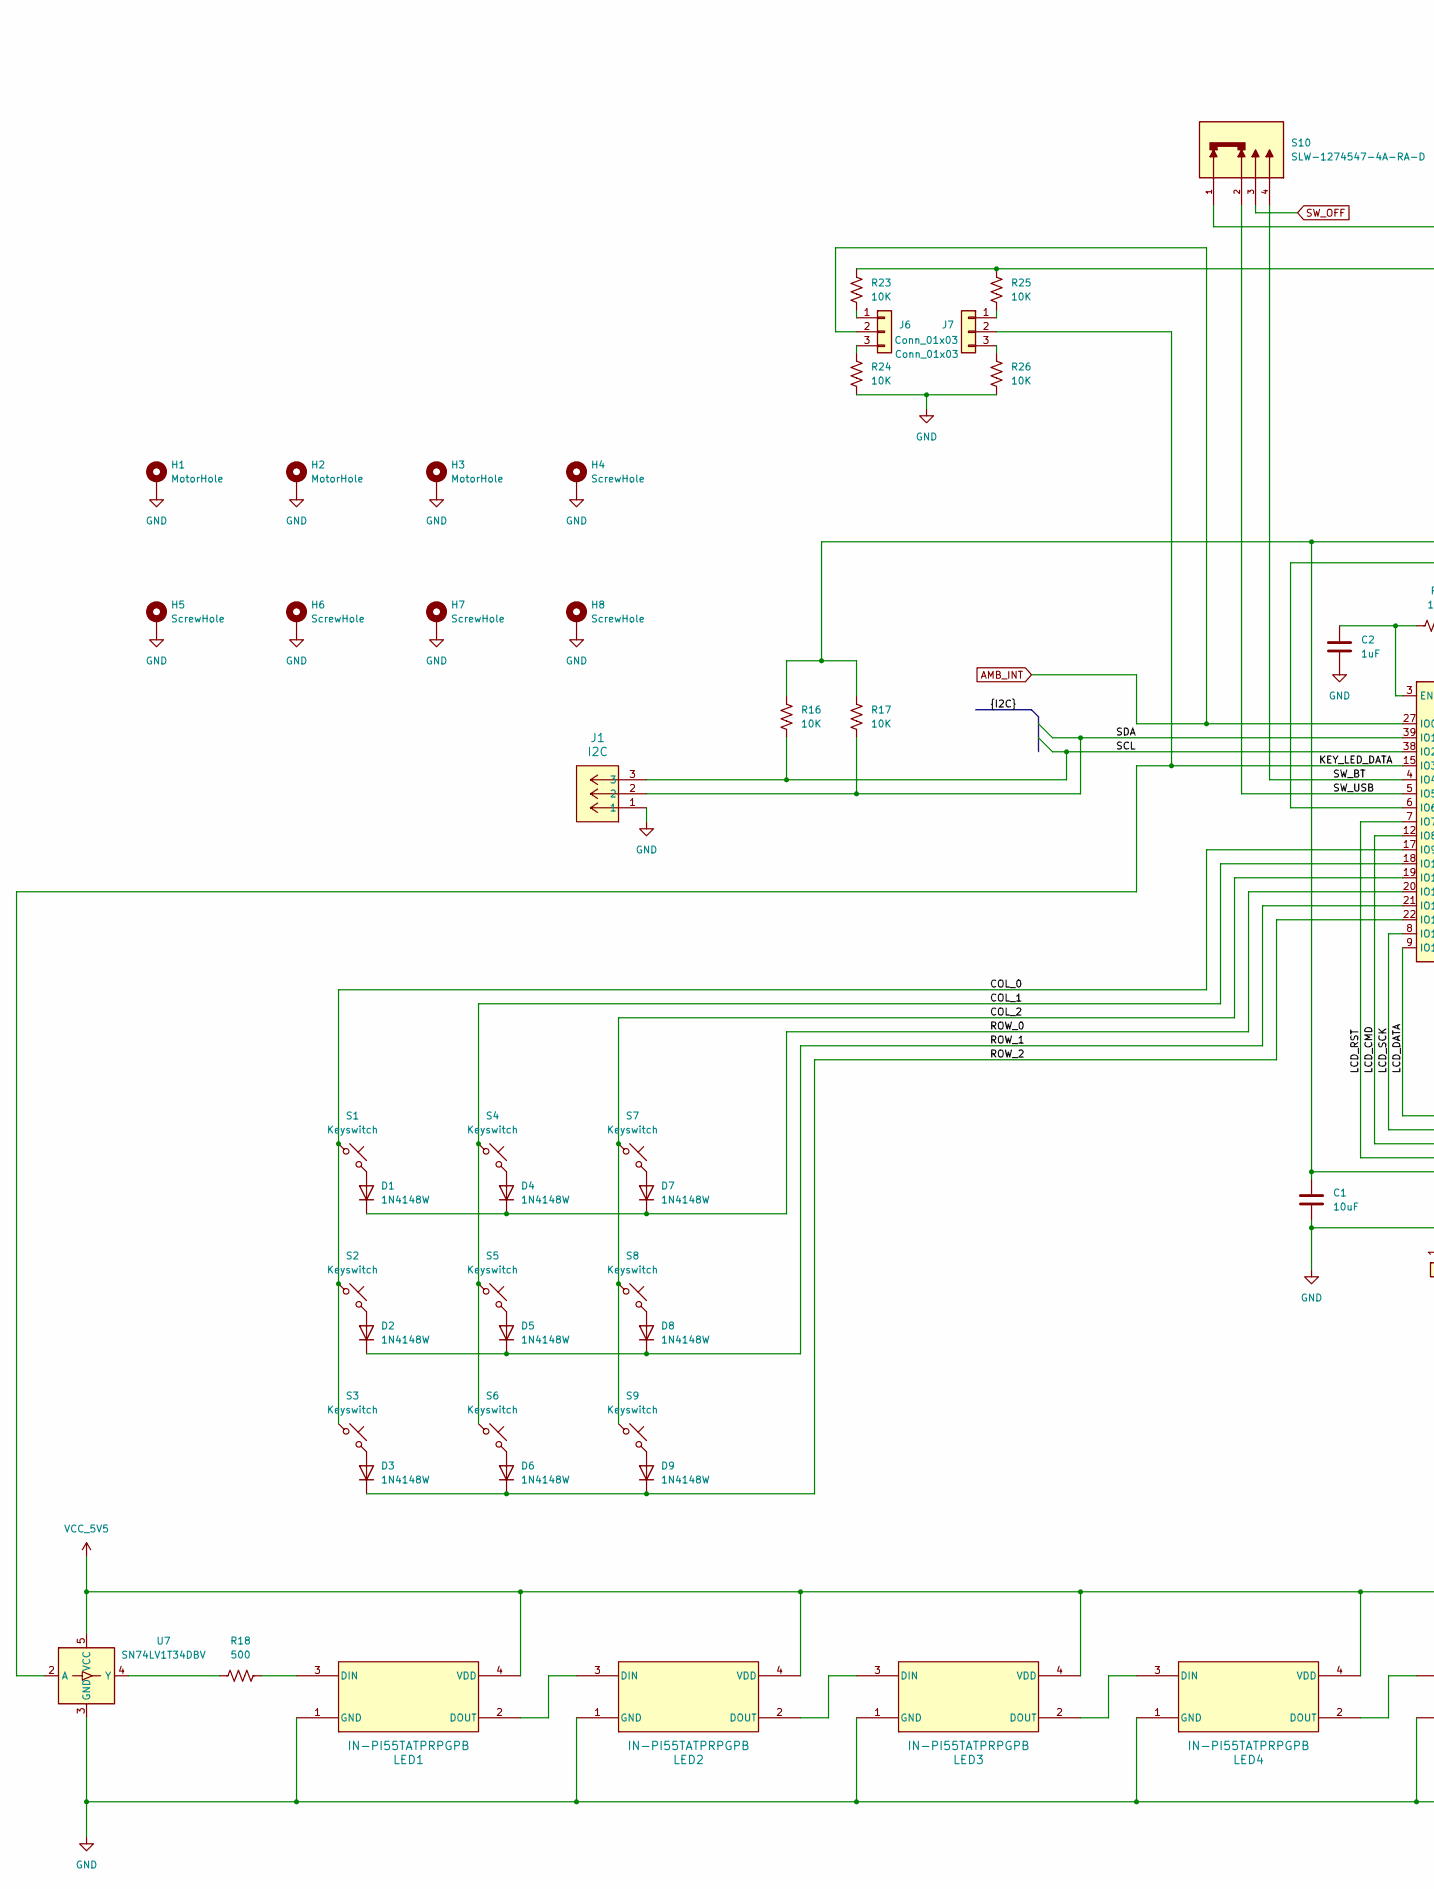
[picture p11: schematic mcu.kicad_sch, part in row 1, column 1]

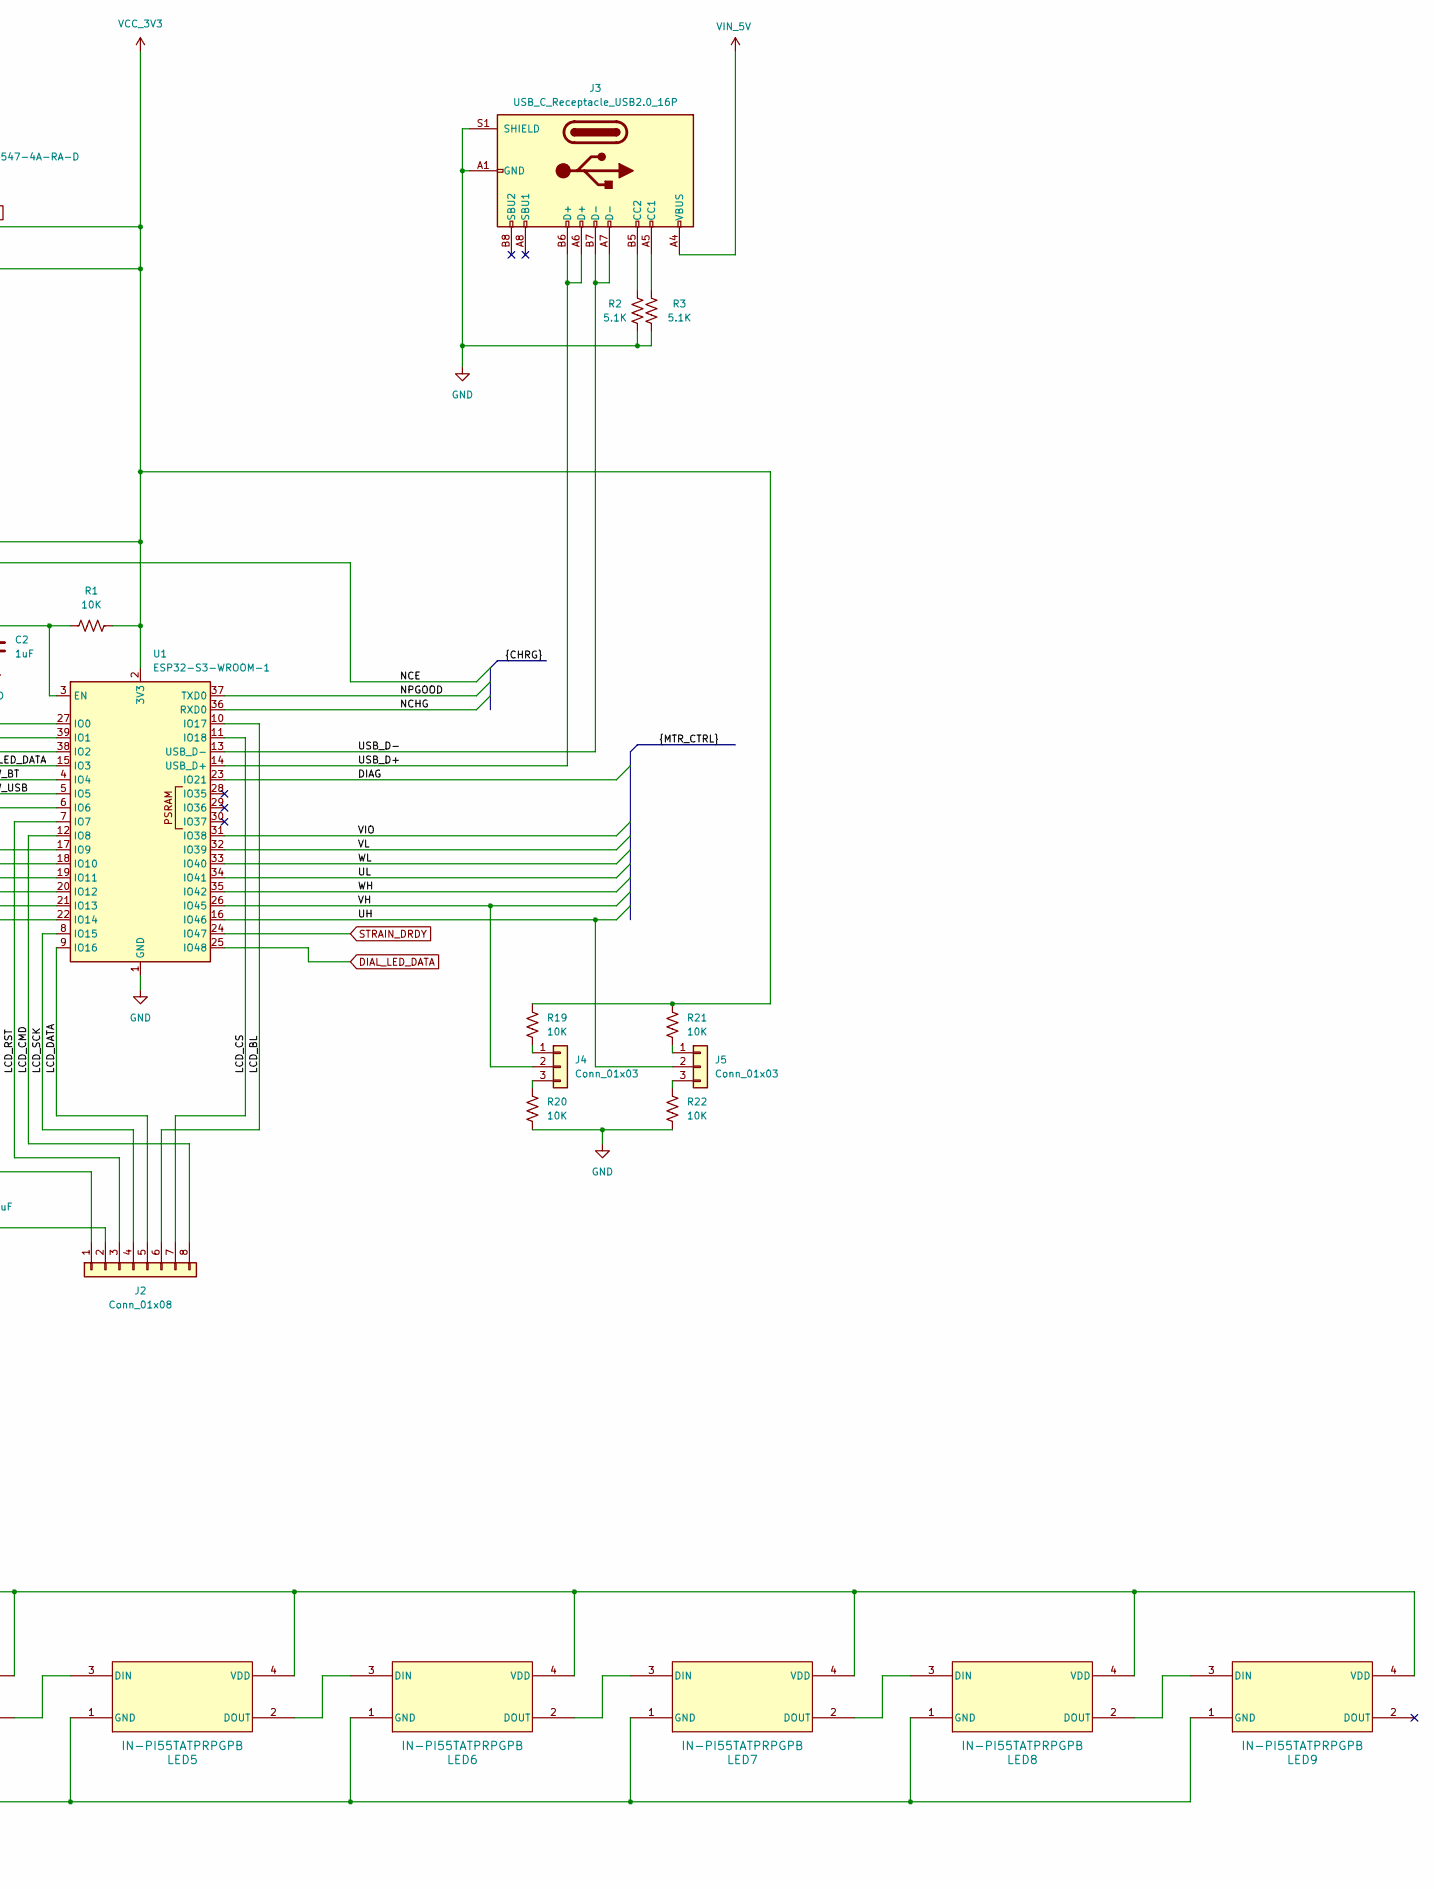
[picture p12: schematic mcu.kicad_sch, part in row 1, column 2]

Parts:
C1: 10uF; C_0603_1608Metric
C2: 1uF; C_0603_1608Metric
D1, D2, D3, D4, D5, D6, D7, D8, D9: 1N4148W; D_SOD-123
H1, H2, H3: MotorHole; MountingHole_M1.6
H4, H5, H6, H7, H8: ScrewHole; MountingHole_2.2mm_M2_ISO7380_Pad
J1: I2C; CONN_A-6373-03A_MOL
J2: Conn_01x08; JST_EH_B8B-EH-A_1x08_P2.50mm_Vertical
J3: USB_C_Receptacle_USB2.0_16P; USB_C_Receptacle_GCT_USB4105-xx-A_16P_TopMnt_Horizontal
J4, J5, J6, J7: Conn_01x03; PinHeader_1x03_P2.54mm_Vertical
LED1, LED2, LED3, LED4, LED5, LED6, LED7, LED8, LED9: IN-PI55TATPRPGPB; LED_IN-PI55TAT_INL
R1, R16, R17, R19, R20, R21, R22, R23, R24, R25, R26: 10K; R_0603_1608Metric
R2, R3: 5.1K; R_0603_1608Metric
R18: 500; R_0603_1608Metric
S1, S2, S3, S4, S5, S6, S7, S8, S9: Keyswitch; MX_PCB_1.00u
S10: SLW-1274547-4A-RA-D; SW_SLW-1274547-4A-RA-D; PARTREV 1.01
U1: ESP32-S3-WROOM-1
U7: SN74LV1T34DBV; SOT-23-5

Connections:
/MCU/COL_0: S1.1, S2.1, S3.1, U1.17 (IO9)
/MCU/COL_1: S4.1, S5.1, S6.1, U1.18 (IO10)
/MCU/COL_2: S7.1, S8.1, S9.1, U1.19 (IO11)
/MCU/DIAG: U1.23 (IO21)
/MCU/KEY_LED_DATA: J7.2, U1.15 (IO3), U7.2 (A)
/MCU/LCD_BL: J2.6, U1.10 (IO17)
/MCU/LCD_CMD: J2.8, U1.12 (IO8)
/MCU/LCD_CS: J2.7, U1.11 (IO18)
/MCU/LCD_DATA: J2.5, U1.9 (IO16)
/MCU/LCD_RST: J2.3, U1.7 (IO7)
/MCU/LCD_SCK: J2.4, U1.8 (IO15)
/MCU/NCE: U1.6 (IO6)
/MCU/NCHG: U1.36 (RXD0)
/MCU/NPGOOD: U1.37 (TXD0)
/MCU/ROW_0: D1.1 (K), D4.1 (K), D7.1 (K), U1.20 (IO12)
/MCU/ROW_1: D2.1 (K), D5.1 (K), D8.1 (K), U1.21 (IO13)
/MCU/ROW_2: D3.1 (K), D6.1 (K), D9.1 (K), U1.22 (IO14)
/MCU/SCL: J1.3, R16.2, U1.38 (IO2)
/MCU/SDA: J1.2, R17.2, U1.39 (IO1)
/MCU/SW_BT: S10.4, U1.4 (IO4)
/MCU/SW_USB: S10.2, U1.5 (IO5)
/MCU/UH: J5.2, U1.16 (IO46)
/MCU/UL: U1.34 (IO41)
/MCU/USB_D+: J3.A6 (D+), J3.B6 (D+), U1.14 (USB_D+)
/MCU/USB_D-: J3.A7 (D-), J3.B7 (D-), U1.13 (USB_D-)
/MCU/VH: J4.2, U1.26 (IO45)
/MCU/VIO: U1.31 (IO38)
/MCU/VL: U1.32 (IO39)
/MCU/WH: U1.35 (IO42)
/MCU/WL: U1.33 (IO40)
AMB_INT: J6.2, U1.27 (IO0); also elsewhere on the board
DIAL_LED_DATA: U1.25 (IO48); also elsewhere on the board
GND: C1.2, C2.2, H1.1, H2.1, H3.1, H4.1, H5.1, H6.1, H7.1, H8.1, J1.1, J2.2, J3.A1 (GND), J3.A12 (GND), J3.B1 (GND), J3.B12 (GND), J3.S1 (SHIELD), LED1.1 (GND), LED2.1 (GND), LED3.1 (GND), LED4.1 (GND), LED5.1 (GND), LED6.1 (GND), LED7.1 (GND), LED8.1 (GND), LED9.1 (GND), R2.2, R3.2, R20.2, R22.2, R24.2, R26.2, U1.1 (GND), U1.40 (GND), U1.41 (GND), U7.3 (GND); also elsewhere on the board
unnamed: D1.2 (A), S1.2
unnamed: D2.2 (A), S2.2
unnamed: D3.2 (A), S3.2
unnamed: D4.2 (A), S4.2
unnamed: D5.2 (A), S5.2
unnamed: D6.2 (A), S6.2
unnamed: D7.2 (A), S7.2
unnamed: D8.2 (A), S8.2
unnamed: D9.2 (A), S9.2
unnamed: J3.A5 (CC1), R3.1
unnamed: J3.B5 (CC2), R2.1
unnamed: J4.1, R19.2
unnamed: J4.3, R20.1
unnamed: J5.1, R21.2
unnamed: J5.3, R22.1
unnamed: J6.1, R23.2
unnamed: J6.3, R24.1
unnamed: J7.1, R25.2
unnamed: J7.3, R26.1
unnamed: LED1.3 (DIN), R18.2
unnamed: LED1.2 (DOUT), LED2.3 (DIN)
unnamed: LED2.2 (DOUT), LED3.3 (DIN)
unnamed: LED3.2 (DOUT), LED4.3 (DIN)
unnamed: LED4.2 (DOUT), LED5.3 (DIN)
unnamed: LED5.2 (DOUT), LED6.3 (DIN)
unnamed: LED6.2 (DOUT), LED7.3 (DIN)
unnamed: LED7.2 (DOUT), LED8.3 (DIN)
unnamed: LED8.2 (DOUT), LED9.3 (DIN)
unnamed: C2.1, R1.1, U1.3 (EN)
unnamed: R18.1, U7.4 (Y)
STRAIN_DRDY: U1.24 (IO47); also elsewhere on the board
SW_OFF: S10.3; also elsewhere on the board
VCC_3V3: C1.1, J2.1, R1.2, R16.1, R17.1, R19.1, R21.1, R23.1, R25.1, S10.1, U1.2 (3V3); also elsewhere on the board
VCC_5V5: LED1.4 (VDD), LED2.4 (VDD), LED3.4 (VDD), LED4.4 (VDD), LED5.4 (VDD), LED6.4 (VDD), LED7.4 (VDD), LED8.4 (VDD), LED9.4 (VDD), U7.5 (VCC); also elsewhere on the board
VIN_5V: J3.A4 (VBUS), J3.A9 (VBUS), J3.B4 (VBUS), J3.B9 (VBUS); also elsewhere on the board

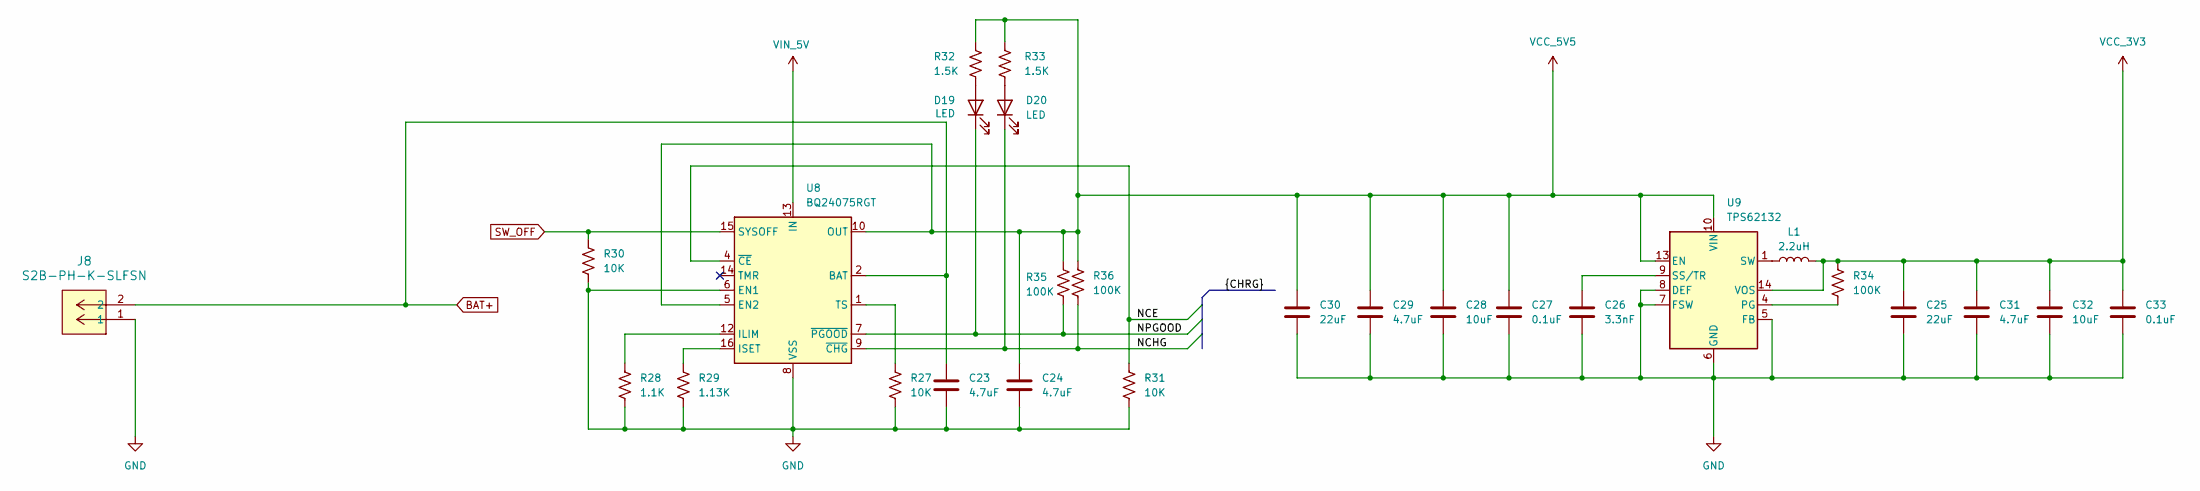
[picture p13: schematic power.kicad_sch]

Parts:
C23, C24, C29, C31: 4.7uF; C_0603_1608Metric
C25, C30: 22uF; C_0603_1608Metric
C26: 3.3nF; C_0603_1608Metric
C27, C33: 0.1uF; C_0603_1608Metric
C28, C32: 10uF; C_0603_1608Metric
D19, D20: LED; LED_0603_1608Metric
J8: S2B-PH-K-SLFSN; JST_PH_S2B-PH-K_1x02_P2.00mm_Horizontal
L1: 2.2uH; L_0805_2012Metric
R27, R30, R31: 10K; R_0603_1608Metric
R28: 1.1K; R_0603_1608Metric
R29: 1.13K; R_0603_1608Metric
R32, R33: 1.5K; R_0603_1608Metric
R34, R35, R36: 100K; R_0603_1608Metric
U8: BQ24075RGT; VQFN-16-1EP_3x3mm_P0.5mm_EP1.6x1.6mm
U9: TPS62132; VQFN-16-1EP_3x3mm_P0.5mm_EP1.68x1.68mm_ThermalVias

Connections:
/Power/NCE: R31.1, U8.4 (~CE)
/Power/NCHG: D20.1 (K), R36.2, U8.9 (~CHG)
/Power/NPGOOD: D19.1 (K), R35.2, U8.7 (~PGOOD)
BAT+: C23.1, J8.2, U8.2 (BAT), U8.3 (BAT); also elsewhere on the board
GND: C23.2, C24.2, C25.2, C26.2, C27.2, C28.2, C29.2, C30.2, C31.2, C32.2, C33.2, J8.1, R27.2, R28.2, R29.2, R30.2, R31.2, U8.6 (EN1), U8.8 (VSS), U8.17 (VSS), U9.5 (FB), U9.6 (GND), U9.7 (FSW), U9.8 (DEF), U9.15 (GND), U9.16 (GND), U9.17 (GND); also elsewhere on the board
unnamed: D19.2 (A), R32.2
unnamed: D20.2 (A), R33.2
unnamed: L1.1, U9.1 (SW), U9.2 (SW), U9.3 (SW)
unnamed: R28.1, U8.12 (ILIM)
unnamed: R29.1, U8.16 (ISET)
unnamed: R27.1, U8.1 (TS)
unnamed: R34.2, U9.4 (PG)
unnamed: C26.1, U9.9 (SS/TR)
SW_OFF: R30.1, U8.15 (SYSOFF); also elsewhere on the board
VCC_3V3: C25.1, C31.1, C32.1, C33.1, L1.2, R34.1, U9.14 (VOS); also elsewhere on the board
VCC_5V5: C24.1, C27.1, C28.1, C29.1, C30.1, R32.1, R33.1, R35.1, R36.1, U8.5 (EN2), U8.10 (OUT), U8.11 (OUT), U9.10 (VIN), U9.11 (VIN), U9.12 (VIN), U9.13 (EN); also elsewhere on the board
VIN_5V: U8.13 (IN); also elsewhere on the board

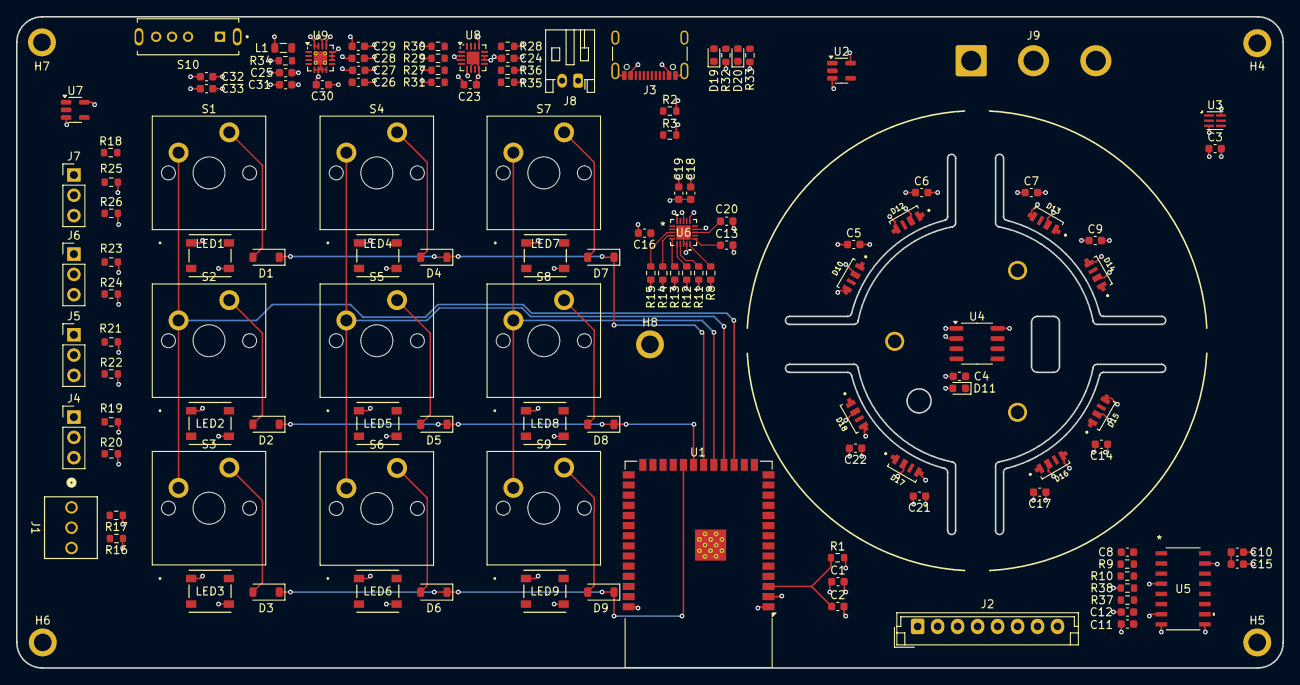
[picture p14: board biro-1-rev-0.kicad_pcb from above]

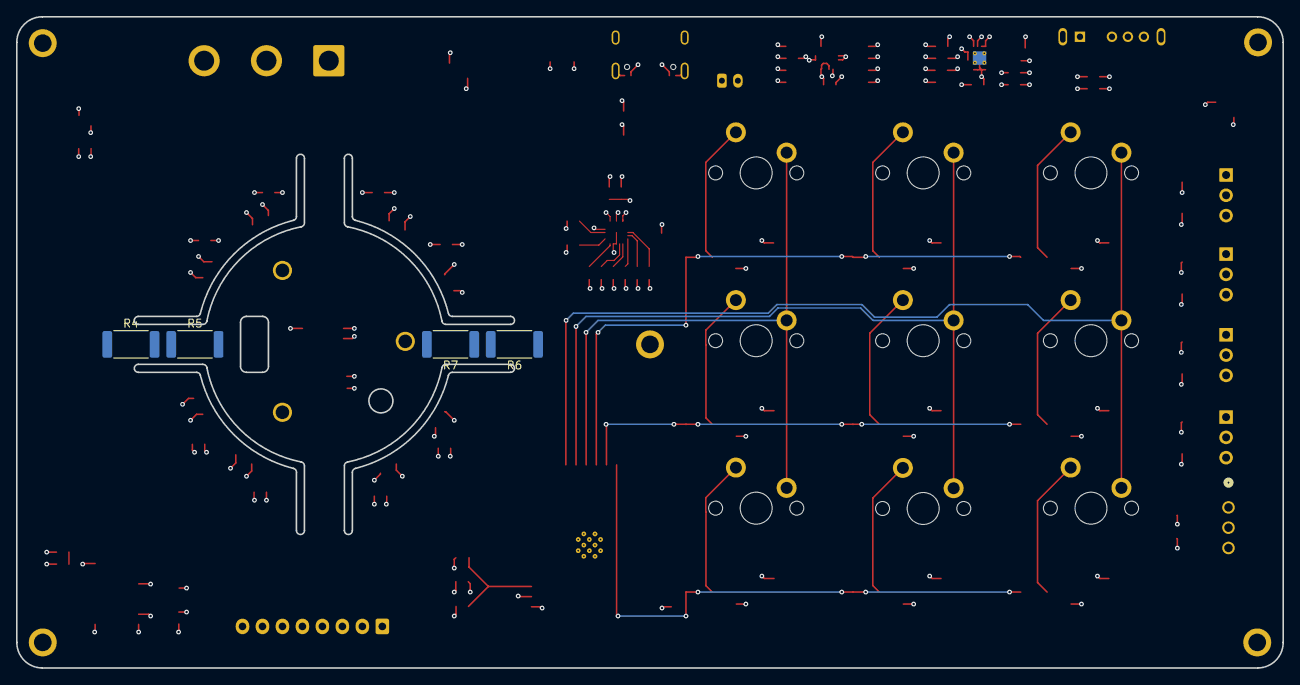
[picture p15: board biro-1-rev-0.kicad_pcb from below]

Board: 4 copper layers, 158.5 x 81.5 mm, 137 parts (4 on the bottom side), 100 nets.
