PROJECT-BIRO/Biro-1/firmware/biro-project-1/electronics/BM28B0.6-24DSBreakout/BM28B0.6-24DSBreakout.kicad_pcb

## KiCad design firmware/biro-project-1/electronics/BM28B0.6-24DSBreakout/BM28B0.6-24DSBreakout.kicad_pcb (2025-03-21)


Parts:
J1, J2: Conn_01x14_Male; PinHeader_1x14_P2.54mm_Vertical
J3: Conn_02x14_Odd_Even; BM28B0.6-24DS

Connections:
/P25: J1.1, J3.25
/P26: J2.1, J3.26
/P27: J1.14, J3.27
/P28: J2.14, J3.28
unnamed: J1.2, J3.1
unnamed: J1.3, J3.3
unnamed: J1.4, J3.5
unnamed: J1.5, J3.7
unnamed: J1.6, J3.9
unnamed: J1.7, J3.11
unnamed: J1.8, J3.13
unnamed: J1.9, J3.15
unnamed: J1.10, J3.17
unnamed: J1.11, J3.19
unnamed: J1.12, J3.21
unnamed: J1.13, J3.23
unnamed: J2.2, J3.2
unnamed: J2.3, J3.4
unnamed: J2.4, J3.6
unnamed: J2.5, J3.8
unnamed: J2.6, J3.10
unnamed: J2.7, J3.12
unnamed: J2.8, J3.14
unnamed: J2.9, J3.16
unnamed: J2.10, J3.18
unnamed: J2.11, J3.20
unnamed: J2.12, J3.22
unnamed: J2.13, J3.24



Board: 2 copper layers, 15.2 x 35.6 mm, 3 parts (2 on the bottom side), 28 nets.
