PROJECT-BIRO/Biro-1/firmware/biro-project-1/electronics/LevelShifterBreakout/LevelShifterBreakout.kicad_pcb

## KiCad design firmware/biro-project-1/electronics/LevelShifterBreakout/LevelShifterBreakout.kicad_pcb (2025-03-21)


Parts:
C1, C2: 0.1uF; C_0805_2012Metric_Pad1.18x1.45mm_HandSolder
J1, J2: Conn_01x08_Male; PinHeader_1x08_P2.54mm_Vertical
U1: SN74AVC4T774RSVR; Texas_Instruments-RSV_R-PUQFN-N16-0-0-0; Voltage - VCCA 1.2V ~ 3.6V; Voltage - VCCB 1.2V ~ 3.6V; mouser part number 595-SN74AVC4T774RSVR; digikey description Voltage Level Translator Bidirectional 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

Connections:
/A1: J1.2, U1.1 (A1)
/A2: J1.3, U1.2 (A2)
/A3: J1.4, U1.3 (A3)
/A4: J1.5, U1.4 (A4)
/B1: J2.2, U1.12 (B1)
/B2: J2.3, U1.11 (B2)
/B3: J2.4, U1.10 (B3)
/B4: J2.5, U1.9 (B4)
/DIR1: J1.6, U1.15 (DIR1)
/DIR2: J1.7, U1.16 (DIR2)
/DIR3: J2.6, U1.5 (DIR3)
/DIR4: J2.7, U1.6 (DIR4)
/VCCA: C1.1, J1.1, U1.14 (VCCA)
/VCCB: C2.1, J2.1, U1.13 (VCCB)
/nOE: J1.8, U1.7 (~OE~)
GND: C1.2, C2.2, J2.8, U1.8 (GND)



Board: 2 copper layers, 15.2 x 20.3 mm, 5 parts (2 on the bottom side), 16 nets.
