PROJECT-BIRO/Biro-1/(commit log)

2025-03-16 Added dial code over to our project
    [BM28B0.6-24DSBreakout.kicad_pcb, BM28B0.6-24DSBreakout.sch, LevelShifterBreakout.kicad_pcb, LevelShifterBreakout.sch, configuration.h, partitions-4MB-fat.csv, view_base.kicad_pcb, view_base.kicad_sch]
2025-03-16 Updated platformio.ini file to change to our board
2025-03-23 added battery schematic
    [biro-0.kicad_pcb, biro-0.kicad_sch]
2025-05-02 Serial Monitoring Fixed (#17)
    * disable hardware
    * program works
    ---------
    [main.cpp]
2025-09-03 Schematic Rev 0 (#15)
    * Initial kicad files for Rev 0 schematic
    * Removed stale files
    * Added lib
    * Added pdf
    * Changed PSRAM pins
    * Updated TMC6300 VIO cap to 100nF
    * Added I2C pullups and LCD net labels
    * Added key LEDs
    * Added strapping GPIO pull-up/-down options, replaced UART breakout with charging status signals
    * Updated pdf
    * Added power circuitry
    * First crack at layout, added scottokeebs 3d files
    * Added battery divider to ADC, created board step file, updated to kicad 9
    * Added mounting holes, minor schematic fixes, layout progress
    [biro-1-rev-0.kicad_pcb, biro-1-rev-0.kicad_sch, biro-1-rev-0.step, dial.kicad_sch, mcu.kicad_sch, power.kicad_sch]
